Gloria-Deng/epv32/docs/附图/fig_a_operator_bars.png

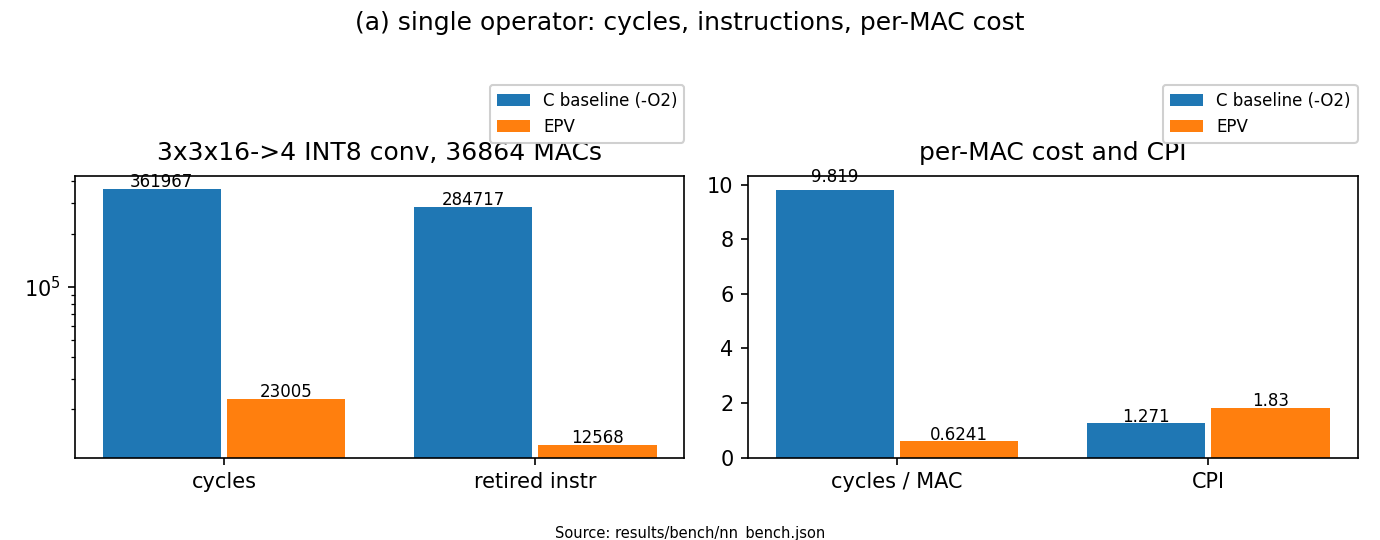
docs/附图/fig_a_operator_bars.png
