Gloria-Deng/epv32/docs/附图/fig_b_layer_stack.png

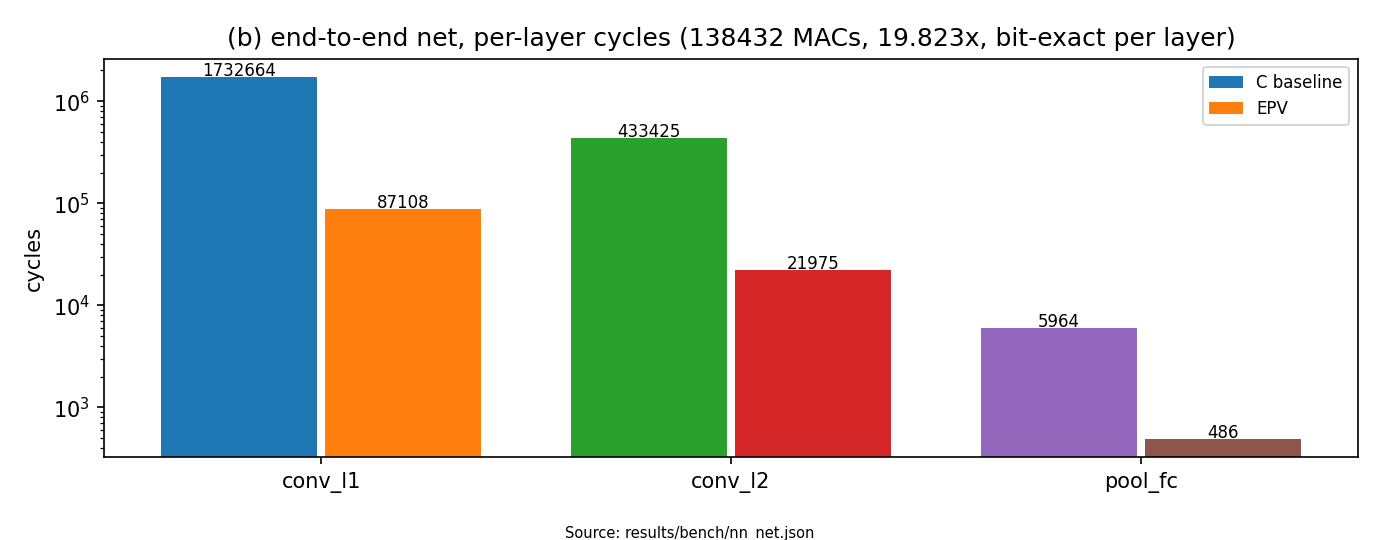
docs/附图/fig_b_layer_stack.png
