Gloria-Deng/epv32/docs/附图/fig_c_device_resources.png

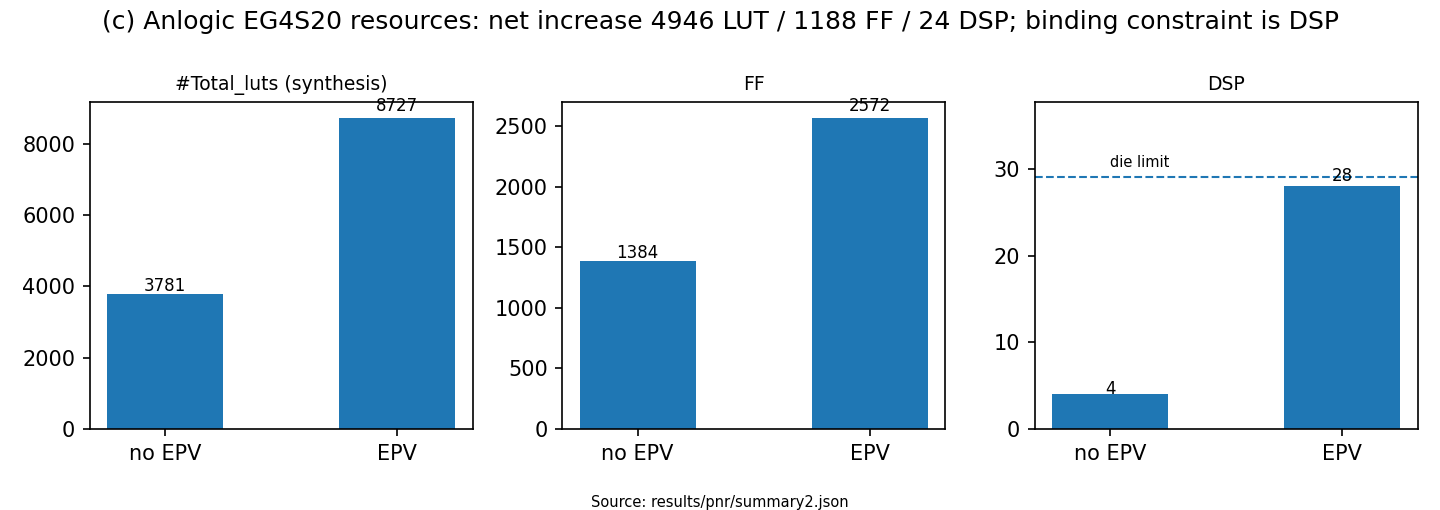
docs/附图/fig_c_device_resources.png
