Gloria-Deng/epv32/docs/附图/fig_d_speedup_waterfall.png

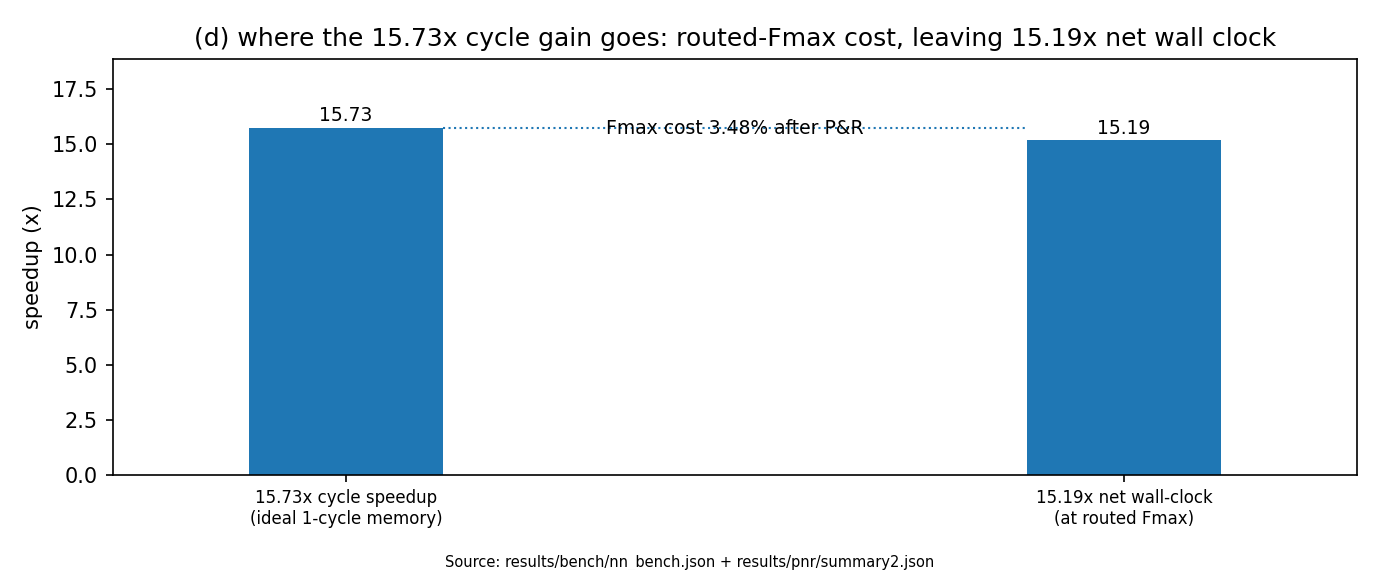
docs/附图/fig_d_speedup_waterfall.png
