Gloria-Deng/epv32/docs/附图/fig_e_compliance.png

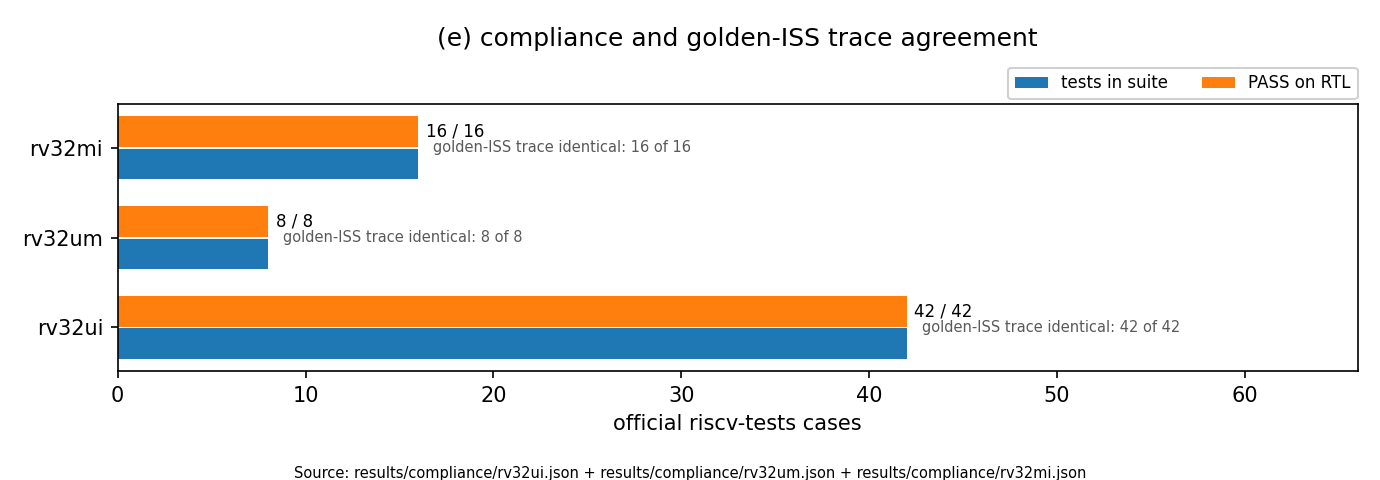
docs/附图/fig_e_compliance.png
