Gloria-Deng/epv32/docs/附图/fig_f_yosys_area.png

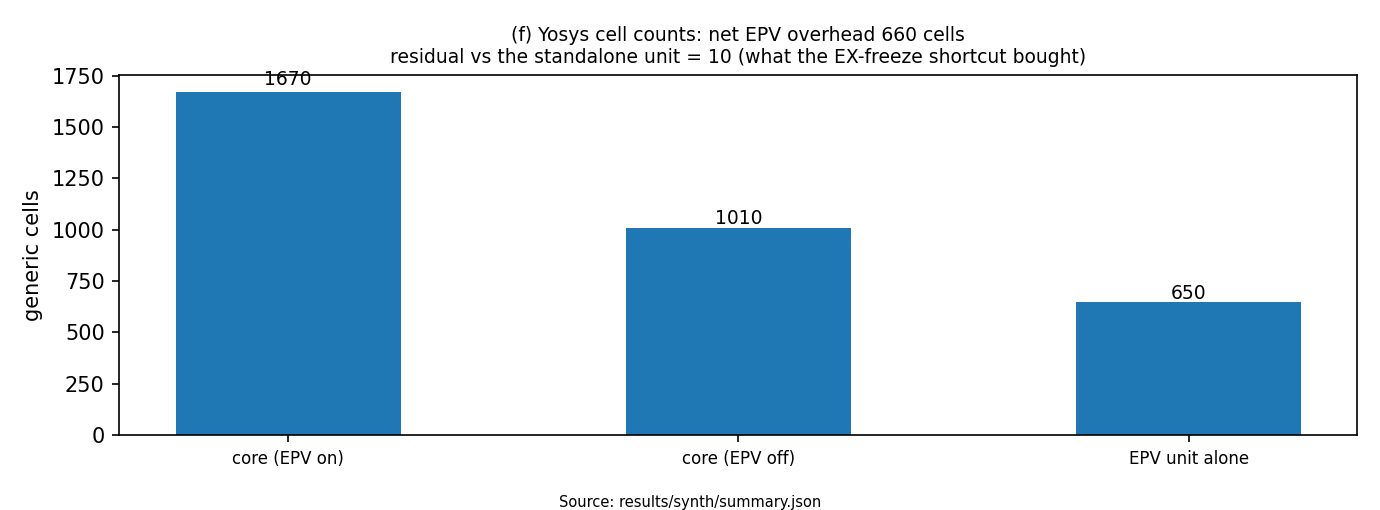
docs/附图/fig_f_yosys_area.png
