Gloria-Deng/epv32/docs/附图/fig_g_cifar10_accuracy.png

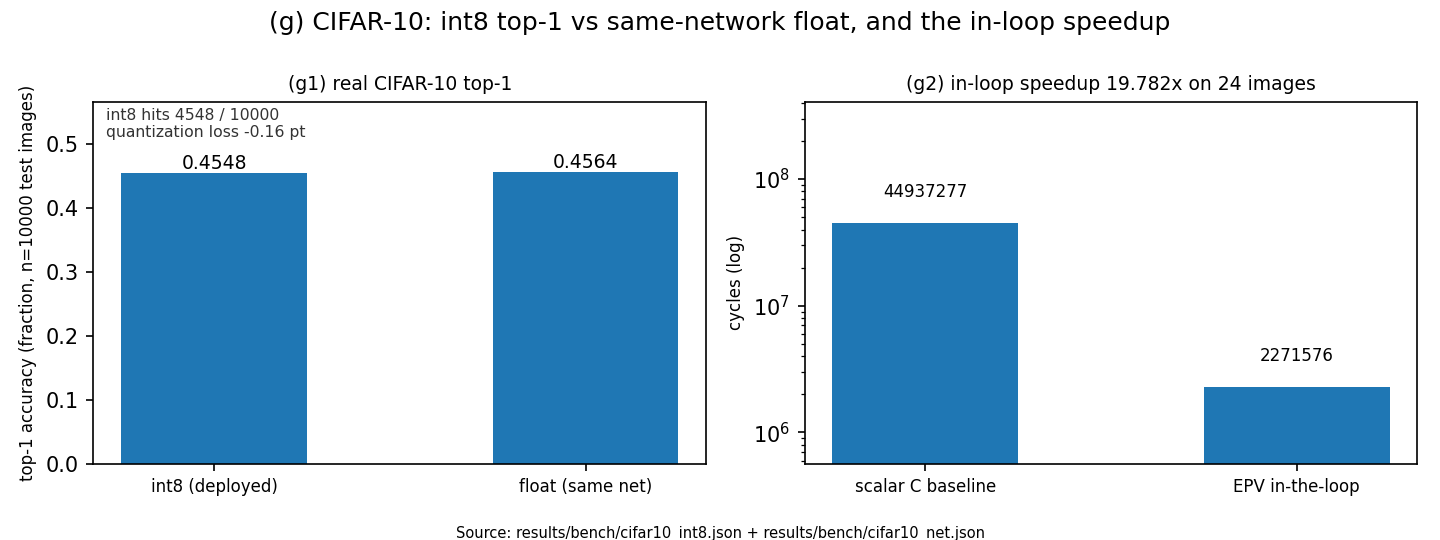
docs/附图/fig_g_cifar10_accuracy.png
