Gloria-Deng/epv32/docs/附图/fig_h_mem_penalty_curve.png

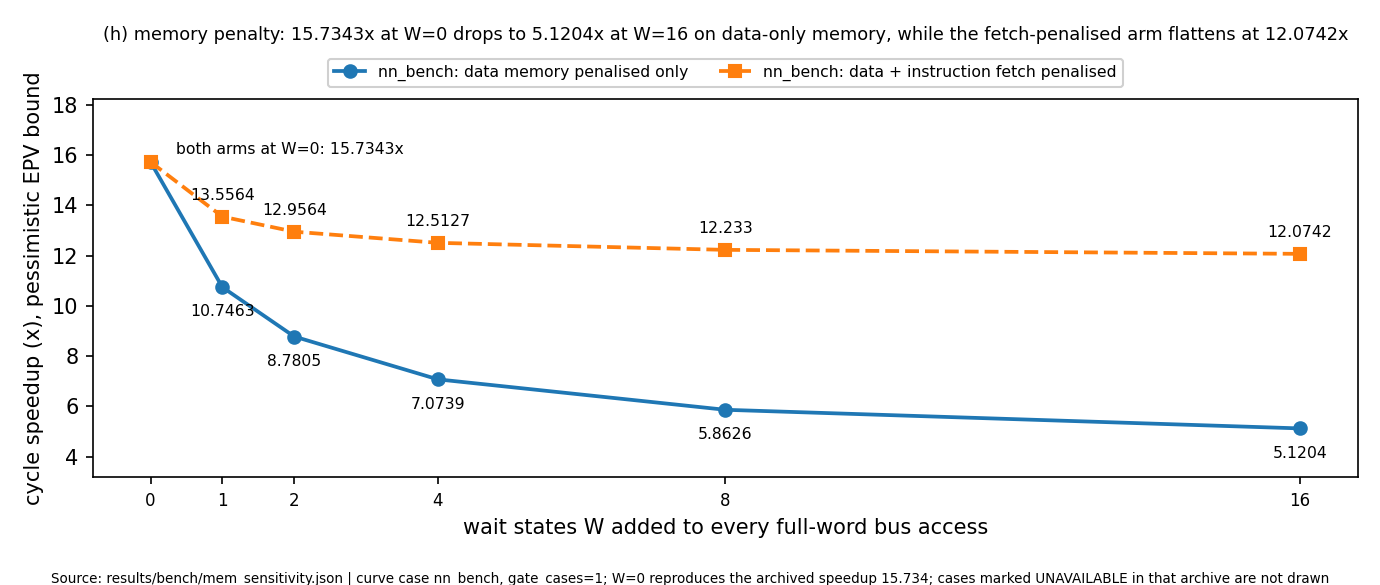
docs/附图/fig_h_mem_penalty_curve.png
