Gloria-Deng/epv32/tb/golden/epv_iss.py

#!/usr/bin/env python3
# -*- coding: utf-8 -*-
# =============================================================================
#  epv_iss.py -- GOLDEN REFERENCE INSTRUCTION-SET SIMULATOR for the EPV32 core
#
#  WHAT THIS IS
#    纯标准库 (Python 3.11) 的提交级指令模拟器, 覆盖 rtl/epv32_soc.v +
#    rtl/epv32_core.v (RV32IM + Zicsr + machine mode) 与自定义 EPV 扩展
#    (CUSTOM0/CUSTOM1)。它是核对 RTL 的黄金模型: 一次 step() == 一条退休指令,
#    与 o_tr_* 退休轨迹 1:1 对齐; 流水线停顿、32 拍除法器、4 拍 LVB/SVB 都折进单次提交。
#
#  SOURCE OF TRUTH (read these before changing anything in here)
#    rtl/epv32_defs.vh   opcodes / EPV encoding / memory map / exception codes
#    rtl/epv32_epv.v     exact arithmetic of every EPV operation
#    rtl/epv32_core.v    legality decode + trap priority + retire trace
#    rtl/epv32_csr.v     CSR behaviour, interrupt arbitration, mcycle/minstret
#    rtl/epv32_muldiv.v  RV32M corner cases
#    rtl/epv32_ram.v     byte addressed, 4 byte enables, index = addr[AW+1:2]
#
#  DELIBERATE DEVIATIONS FROM THE RTL
#    历史上这里有三条「模型按规范、RTL 有 bug」的开关。到 M8 为止三条都已经在
#    RTL 里修掉了，所以 MIRROR_RTL_DECODE_BUGS 现在**换不出任何行为差异**——
#    留着它不是为了兼容，而是为了让"合流"这件事本身可被反驳：自检里有一条断言
#    专核 rtl_* == spec_*，并且要求 legacy_*（旧 RTL 形状）确实与两者不同，
#    否则那条合流断言就是空跑。三条的来历：
#    MIRROR_RTL_DECODE_BUGS (default False)
#      (1) 旧 epv32_core.v 的 `imm_op_bad` 把每条 SLLI 都判非法、且把 SRAI
#          (inst[30]=1) 与 ORI(imm[10]=1) 一起判非法 —— rv32ui/add 在第一条
#          slli 就 cause=2。现行判据见上面 imm_bad_* 四个函数。
#      (2) 旧 `m_f3_ok` 只收 f3 ∈ {0,1,2,3,6,7}，于是 DIV(f3=4)/DIVU(f3=5)
#          被判非法 —— rv32um/div 栽过。现行 RTL 恒不判非法。
#      (3) 旧 `other_f3_bad` 对 LUI/AUIPC/JAL 也校验 [14:12]，而那是 U/J 型
#          立即数的一部分 —— 任何 imm[14:12]!=0 的 lui/auipc/jal 都陷入。
#          现行 RTL 只对 JALR 校验。
#    MIRROR_RTL_MTVEC_MODE_BIT (default False)
#      epv32_csr.v:81 `wire vmode_vec = mtvec[1];` decodes the vectored mode
#      from bit 1, but mtvec MODE is a 2-bit WARL field where 0 = Direct and
#      1 = Vectored, so the standard encoding mtvec = base|1 selects DIRECT and
#      base|2 selects VECTORED on this hardware -- the opposite of the spec (and
#      of the design brief).  Golden: (mtvec & 3) == 1 means vectored.
#    MIRROR_RTL_BRANCH_OPERAND_BUG (default False)
#      epv32_core.v:254 gives a BRANCH `d_b_imm=1`, and epv32_core.v:367 is
#      `assign alu_b = idex_b_imm ? idex_imm : fwd2;` -- so the branch ALU
#      computes rs1 OP branch_offset and BEQ/BNE/BLT/BGE test THAT result
#      (only BLTU/BGEU, which compare fwd1/fwd2 directly at line 405, work).
#      In hardware BEQ is therefore taken iff rs1 == offset, and BLT iff
#      rs1 < offset.  The golden model compares the two GPR operands; set the
#      flag True to reproduce the hardware's branch decisions exactly.
#    EPV_MEM_ADDR_STRIDE_X4 (default True)
#      Today's epv32_epv.v walks the four beats as base + wc*4 (four
#      consecutive words) -- which is what the golden default models.  Setting
#      it False reproduces the PRE-fix addressing bug (the ledger-defect-11
#      era: base + wc, so all four beats hit one word); the switch exists so
#      that historical failure mode stays reproducible, not because the
#      hardware still behaves that way.
#    EPV_MEM_IMM_UNUSED (default True)
#      The R-type migration removed the immediate from EPV.LVB / EPV.SVB
#      entirely: epv32_epv.v still takes i_imm but nothing consumes it, and
#      the transfer address is exactly rs1 + 4*beat.  The software intrinsic
#      keeps off in the base register for that reason (sw/inc/epv32_hw.h
#      epv_lvb).  Setting it False revives the I-type-era behaviour (adding
#      imm[11:0], zero- or sign-extended per EPV_IMM_ZERO_EXTENDS) so the old
#      encoding-collision analyses stay reproducible; quirk 17 records what
#      that era implied.
#
#  CYCLE MODEL v2 -- READ THIS BEFORE USING mtime / mcycle / UART STATUS / IRQs
#  (design brief item 5; v1 counted 1 cycle per retired instruction, which made
#   mcycle/mtime a lower bound and TIMER-IRQ timing "not a golden property".
#   That is gone: since the EPV trace comparison the ISS carries an EXACT
#   microarchitectural clock, validated point-by-point against the mcycle read
#   values the RTL records in its retirement traces.)
#    One step() == one retired instruction, AND a precise place on the RTL's
#    clock.  For instruction i the model computes the cycle where its EX stage
#    actively evaluates (reset fill: first instruction is in EX at cycle 2,
#    counting the first post-reset cycle as 0), then:
#      +1  load-use hazard: the previous instruction is a LOAD whose rd field
#          matches this instruction's rs1/rs2 FIELD, using the RTL's coarse
#          per-opcode uses_rs1/uses_rs2 wires (epv32_core.v:272-278) -- an EPV
#          op counts as using both fields even when it semantically does not;
#      +2  the previous instruction redirected (taken branch/jump, mret, trap
#          or IRQ): two flushed slots ahead of the target;
#      +1  the previous instruction was a word/half access CROSSING a word
#          boundary: its second MEM beat holds the pipeline one extra cycle
#          (only for single-cycle successors; a DIV/LVB started during that
#          hold absorbs it into its own busy count);
#     +32  DIV/REM/REMU/DIVU frozen in EX (1 start + 32 working beats,
#          epv32_muldiv.v "完成拍 = 第 33 拍");
#      4+g LVB/SVB: 4 granted bus beats; g = grant waits caused by the
#          previous instruction still occupying MEM (1 for a plain load/store,
#          2 if it crossed a word boundary; 0 when a load-use hazard already
#          delayed this instruction past the previous MEM beat).
#    Everything else is 1 cycle.  Bus reads sample the device state at the
#    instruction's MEM cycle (EX+1); LVB/SVB beats sample at their own beat
#    cycles; CSR reads sample mcycle at the EX cycle.  The UART send shift
#    register is modelled edge-by-edge (see _uart_edge), so a STATUS poll
#    returns the live tx_idle bit -- busy-wait loops now wait exactly as long
#    as the hardware does.  mtime is the real free-running clock; mcycle is
#    the same clock unless software writes it or inhibits it (overlay, see
#    _mcycle_now).  `cycles_per_step` / `set_cycle_model()` still exist as a
#    legacy escape hatch: setting either switches the ISS back to flat
#    per-step charging and disables the exact placement.
#    CONSEQUENCE: TIMER-IRQ timing and UART poll values ARE golden properties
#    now, and a mcycle read value in a retirement trace is a point check of
#    the whole model (all of them must match the RTL bit-for-bit).
#
#  RTL_QUIRKS mirrored faithfully by this model (deliberately NOT "fixed"):
#   1. Trap priority is exactly epv32_core.v:425-434: illegal > instruction
#      access fault > branch target > jump target > ebreak > ecall > address
#      misaligned > access fault.
#   2. Control-transfer targets are checked in EX with the SAME expression on
#      both sides: a branch is judged only when it is TAKEN (M5), and both
#      branch and jump targets must be in the memory map AND satisfy IALIGN=32
#      (M7: jalr already cleared bit0, so the alignment test looks at bit1).
#      Either way the cause is 0 with mtval = target.  History: before M5 a
#      not-taken branch trapped anyway; before M7 an in-range but halfword
#      misaligned target did NOT trap at all -- it fetched the aligned word and
#      used the misaligned address as PC, so auipc came out 2 bytes off
#      (measured: results/sim/misalign_bisect_pre_m7.json, uart "C2
#      flag=11ce0000").  Both deviations are gone; this entry documents what
#      the model must NOT reproduce.
#   3. (pre-M6 legacy, kept reachable) addr_ok() used to demand 4-byte
#      alignment for EVERY access, so LB/SB at addr%4!=0 reported LOAD/STORE
#      ACCESS FAULT (5/7).  Now the alignment tier follows the access width
#      (byte: none; half: addr[0]; word: addr[1:0]), and with SUPPORT_MISALIGNED
#      the core splits a crossing access in MEM instead of trapping.  Set
#      ADDR_OK_OLDED_ALIGNMENT=True to reproduce the legacy reading.
#   4. Exceptions enter at mtvec with the low two MODE BITS MASKED OFF
#      (epv32_core.v: `trap_target = irq_now ? csr_irq_target : csr_mtvec_base`
#      where csr_mtvec_base = {mtvec[31:2], 2'b00}); interrupts use
#      mtvec_base / the vectored offset.  An older core line selected o_mtvec
#      verbatim and the model mirrored that (the old quirk 4); under that
#      reading a vectored-mode mtvec sent exceptions to a misaligned address.
#      The CSR REGISTER still holds the raw mode bits unwritten (no WARL
#      masking on write) -- it is only the exception ENTRY that is masked.
#   5. LOAD with f3==7 is not rejected (ld_f3_bad covers only 3 and 6) and
#      behaves like LW; OP / OP-IMM with an unhandled funct3 fall through to ADD.
#   6. Undefined CSR address: reads 0, writes ignored, NO trap (documented in
#      epv32_csr.v:10-12 as an intentional boundary).  Read-only CSRs (mip,
#      misa, mvendorid..., vcfg) also swallow writes.  M9 moved mcycle*/
#      minstret* out of that list: they are writable and the writing
#      instruction suppresses its own increment (quirk 18).
#   7. CSRRS/CSRRC suppress the write when the FORWARDED DATA is 0, not when
#      the register number is x0 (epv32_csr.v:127 tests i_wdata == 32'h0).
#   8. MPP reads as 00 until the first trap / mret / mstatus write forces 11:
#      epv32_csr.v resets mstatus to 0 and only ever assigns bits 12:11.
#   9. mret retires nothing (ex_commit excludes mret_go), so minstret does not
#      count mret and the retire trace has no mret entry.
#  10. EPV field_bad (epv32_epv.v:96-98) is THREE PER-OP MASKS, not an
#      unconditional rd/rs2/rs1 check: rd_is_vec covers MVX plus every CUSTOM1
#      op except VDOT8; rs2_is covers LVB/SVB plus the two-source CUSTOM1 ops;
#      rs1_is covers CUSTOM1 except VDOT8/VZERO.  So XMV / CFG / CFGR / LVB /
#      SVB / VDOT8 all legally take rd >= 8, MVX / XMV / CFG / CFGR may carry
#      rs2[4:3] != 0, and no CUSTOM0 op checks rs1.  This model used to check
#      rd/rs2 unconditionally and its own self test pinned that (as "VDOT8
#      rd=8 -> illegal"); the RTL never rejected those encodings -- the whole
#      program trace comparison died on `EPV.CFGR x11`.  Corrected here and
#      re-pinned per-op, both directions, in self test section 10.
#  11. EPV.XMV reads the rs2 FIELD (epv32_epv.v `c0_xmv ? s2[31:0]`, "XMV 的
#      向量号在 [24:20] => s2"), matching sw/inc/epv32_hw.h epv_xmv(rd, vs2)
#      which puts vs2 in [24:20] and x0 in rs1.  An earlier RTL line read s1
#      and this model mirrored that as the old quirk 11 ("reads vrf[rs1f]");
#      the EPV trace comparison caught the staleness the day the UART cycle
#      model let it reach the first VDOT8 -- a vreg loaded via LVB came back
#      as lane-0-of-v0 instead of the requested vector.  Corrected here; the
#      field-presence legality (XMV's rd is a real GPR, rs2 is a vec number)
#      was already right and stands.
#  12. VREQ4 adds RB SIGN-EXTENDED (int8 zero point): the current epv32_epv.v
#      drives `rb_ext = {{56{v_rb[7]}}, v_rb}`.  History: the first RTL
#      concatenated {55'b0, v_rb} -- unsigned, so RB=0xFF added +255 instead
#      of -1 (ledger defect 13; the golden model flagged it and the old self
#      test only covered positive RB, which is why it could not see the bug).
#      This model mirrored the bug as the old quirk 12 and went stale when
#      the RTL got fixed; the EPV trace comparison caught that too
#      (epv_selftest read +127 where the hardware gives -30).  Both numbers
#      are still pinned, now pointing the right way.
#  13. EPV illegal encodings never reach the bus, and EPV LVB/SVB bus accesses
#      can never fault: the EPV datapath drives neither idex_mem_read nor
#      idex_mem_write, so misaligned/bus_err (gated on c_ld/c_st) cannot fire.
#  14. be_of()'s halfword arm tests off[0] (epv32_core.v:70) where off[1] is the
#      meaningful bit, so SH at addr%4==2 would get be=0b0011 instead of 0b1100.
#      Latent only: such a store never commits because addr_ok() rejects
#      addr%4!=0, so both readings agree on every reachable store.  Kept
#      verbatim for that reason.
#  15. Peripheral reads used to be CLOCKED (rdata <= ... in epv32_soc.v), so a
#      peripheral load returned the PREVIOUS peripheral access's value (STATUS
#      read 3 out of reset); the golden model flagged it (ledger defect 14) and
#      the RTL now drives rdata combinationally (epv32_soc.v:118-124).  The
#      model returns the CURRENT value, which is what today's RTL does; with
#      CYCLE MODEL v2 the UART side of "current" is exact (live tx_idle at the
#      load's MEM cycle), so a STATUS mismatch is once again always a bug.
#  16. epv32_defs.vh:117 documents SYSC CTRL bit0 as "allow commit to end the
#      sim" but epv32_sysc has no CTRL register: ANY write to offset 0 raises
#      commit.  Mirrored (a write to SYSC+0 halts whatever CTRL holds).
#  17. EPV.LVB / EPV.SVB are R-TYPE with the vector number in inst[24:20]
#      (rs2 field): LVB's DESTINATION vector is rs2f[2:0] (epv32_epv.v
#      `vrf[(c0_lvb ? mv_n : vd_n)]`, mv_n = i_rs2f), SVB's SOURCE vector is
#      rs2f[2:0] likewise, rd is x0 in every real encoding, and the immediate
#      field is dead (EPV_MEM_IMM_UNUSED).  On the retirement trace SVB is
#      INVISIBLE as a store: idex_mem_write=0 for CUSTOM0, so o_tr_memwr=0
#      and the testbench prints no S line for it -- the four bus beats exist
#      on the bus but not in the trace.  History: the first encoding was
#      I-type with imm12 = inst[31:20] covering the vs2 field, which made any
#      displacement with imm[4] or imm[3] set unencodable and made "EPV.SVB
#      v6, 0(x9)" transfer from x9+6; the model mirrored that era and its self
#      test pinned it (including four per-SVB store records that the RTL
#      trace never had).  After the R-type migration the collision is gone;
#      the surviving constraint is just the field_bad mask -- the vector
#      number must fit 0..7, i.e. inst[24:20][4:3] == 0 for LVB/SVB.
#  18. minstret / mcycle reads return the value BEFORE the reading instruction
#      counts itself.  As of M9 the RTL increments at the commit stage (EX)
#      rather than at WB -- see epv32_core.v's csr_cnt_wr note for the real
#      ordering bug that forced the move.  The model's observable is unchanged
#      (it counts in program order at commit), so this reading rule stands.
#  19. mcountinhibit.CY(bit0) stops mcycle in the RTL but NOT the SoC's mtime
#      (separate counters in separate modules).  CYCLE MODEL v2 split them:
#      `cycle` is the real free-running clock and drives mtime; the mcycle
#      mirror is an overlay on top of it that honours CY and counter writes
#      (_mcycle_now).  One deliberate simplification: on the edge where one
#      half of mcycle is written, the RTL still increments the OTHER half that
#      same edge (two NBAs, the write only overrides its own half); the overlay
#      suppresses that one increment.  No ISS-vs-RTL comparison reaches a
#      mcycle write today (the suites never read cycle CSRs; micro_bisect has
#      no golden-model arm), so nothing observable rests on the difference.
#      The core-side reading lives in sw/bench/micro_bisect.c item C7.
#  20. PMP *enforcement* (NAPOT/TOR/NA4 match + the three M-mode implicit
#      rules) is in the RTL and in sw/bench/micro_bisect.c, not in this model.
#      None of the three compliance suites can reach it (rv32mi ships pmpaddr
#      only, which tests CSR WARL), so leaving it out cannot mask a mismatch;
#      adding it would mean the trace comparison agrees for a reason it never
#      exercised.  Recorded as an uncovered model path, not as agreement.
# =============================================================================
"""Golden ISS for the EPV32 core: RV32IM + Zicsr + machine mode + EPV ext."""

import sys

__all__ = ["ISS", "StepResult", "Result", "Trap", "SimHalt",
           "ADDR_RAM_BASE", "ADDR_UART_BASE", "ADDR_TIMER_BASE",
           "ADDR_SYSC_BASE"]

# ------------------------------------------------------------------- tunables
MIRROR_RTL_DECODE_BUGS = False       # header deviations 1 and 4
MIRROR_RTL_BRANCH_OPERAND_BUG = False  # header deviation 4 (branches)
MIRROR_RTL_MTVEC_MODE_BIT = False      # header deviation 5 (mtvec mode decode)
EPV_MEM_ADDR_STRIDE_X4 = True        # hardware: four consecutive words
EPV_MEM_IMM_UNUSED = True            # hardware: R-type, the imm field is dead
EPV_IMM_ZERO_EXTENDS = True          # only consulted when EPV_MEM_IMM_UNUSED=0
# rtl/epv32_core.v 的 parameter SUPPORT_UNALIGNED 的镜像:
#   True  = 现在这份核的行为 —— 非对齐访存由硬件拆成两次对齐访问, 不陷入
#   False = 老核的行为 —— 按 cause 4/6 精确陷入
SUPPORT_MISALIGNED = True
# quirk 3 (老核的 addr_ok 要求任何访问都 4 字节对齐) 已经修掉了; 留开关,
# 因为轨迹比对靠的就是"两边同一时刻必须是同一份规则"。
ADDR_OK_OLDED_ALIGNMENT = False

# ------------------------------------------------- opcodes (epv32_defs.vh)
OP_LUI, OP_AUIPC, OP_JAL, OP_JALR, OP_BRANCH, OP_LOAD, OP_STORE = (
    0x37, 0x17, 0x6F, 0x67, 0x63, 0x03, 0x23)
OP_OPIMM, OP_OP, OP_FENCE, OP_SYSTEM, OP_CUSTOM0, OP_CUSTOM1 = (
    0x13, 0x33, 0x0F, 0x73, 0x0B, 0x2B)

# ------------------------------------------------------- ALU ops (defs.vh)
ALU_ADD, ALU_SUB, ALU_SLL, ALU_SLT, ALU_SLTU, ALU_XOR = 0, 1, 2, 3, 4, 5
ALU_SRL, ALU_SRA, ALU_OR, ALU_AND, ALU_MUL, ALU_DIV = 6, 7, 8, 9, 10, 11
ALU_PASS = 15

# ------------------------------------------------- memory map (epv32_defs)
ADDR_RAM_BASE, ADDR_RAM_LAST = 0x8000_0000, 0x8003_FFFF
ADDR_UART_BASE, ADDR_UART_LAST = 0x9000_0000, 0x9000_003F
ADDR_TIMER_BASE, ADDR_TIMER_LAST = 0x9001_0000, 0x9001_003F
ADDR_SYSC_BASE, ADDR_SYSC_LAST = 0x9002_0000, 0x9002_003F

UART_OF_DATA, UART_OF_STATUS, UART_OF_DIV = 0x0, 0x4, 0x8
TMR_OF_MTIME, TMR_OF_MTIMEHI, TMR_OF_CMP, TMR_OF_CMPHI = 0x0, 0x4, 0x8, 0xC
SYSC_OF_COMMIT, SYSC_OF_CTRL, SYSC_OF_SYSID = 0x0, 0x4, 0x8
SYSC_SYSID = 0xE01C_9A53

# ------------------------------------------------ exception codes (defs.vh)
EXC_IAFAIL_ALIGN, EXC_IAF, EXC_ILLEGAL, EXC_BREAK = 0, 1, 2, 3
EXC_LAMF, EXC_LAF, EXC_SAMF, EXC_SAF, EXC_ECM = 4, 5, 6, 7, 11
EXC_NAMES = {0: "instr-address-misaligned", 1: "instr-access-fault",
             2: "illegal-instruction", 3: "breakpoint",
             4: "load-address-misaligned", 5: "load-access-fault",
             6: "store-address-misaligned", 7: "store-access-fault",
             11: "ecall-from-machine-mode"}
IRQ_NAMES = {3: "machine-software-interrupt", 7: "machine-timer-interrupt",
             11: "machine-external-interrupt"}


# ------------------------------------------------ RV32M 的保留编码判据
# 四条规则放在一起，是因为「谁判非法」这件事上模型与 RTL 各有一份实现，
# 一旦两份不同步，逐条轨迹比对就会在某个奇怪的偏移上分叉 —— 而分叉既可能
# 是核错了也可能是模型错了（M8 这次是核错：官方 rv32mi/shamt 只有 ISS 过）。
#   spec   : RISC-V 卷 I（RV32 的 shamt 只有 5 位, inst[25] 必须为 0）
#   rtl    : epv32_core.v 的 imm_op_bad / muldiv_bad, 逐位镜像
#   legacy : M8 之前的 RTL, 只留给自检造反例用
def imm_bad_spec(op, f3, f7):
    return (op == OP_OPIMM) and ((f3 == 1 and f7 != 0x00) or
                                 (f3 == 5 and f7 not in (0x00, 0x20)))


def md_bad_spec(op, f3, f7):
    return False                      # RV32M 八个 funct3 全部合法


def imm_bad_rtl(op, f3, f7):
    return imm_bad_spec(op, f3, f7)   # M8 之后与规范合流


def md_bad_rtl(op, f3, f7):
    return md_bad_spec(op, f3, f7)    # 现在的 RTL 是 `&& !1'b1`, 恒不触发


def imm_bad_legacy(op, f3, f7):
    return (op == OP_OPIMM) and (f3 == 1 or (f3 == 5 and ((f7 >> 5) & 1))
                                 or (f3 == 6 and ((f7 >> 5) & 1)))


def md_bad_legacy(op, f3, f7):
    """旧 RTL 的 muldiv_bad：`m_f3_ok` 只收 {0,1,2,3,6,7}，DIV(4)/DIVU(5) 被漏掉。"""
    return (op == OP_OP) and (f7 == 0x01) and \
        not ((f3 <= 3) or (f3 == 6) or (f3 == 7))

MISA_VALUE = 0x4000_1200             # epv32_csr.v:96
IMPID_VALUE = 0x0000_0003            # epv32_core.v:23 parameter

# ---- M9: 与 rtl/epv32_csr.v 的 parameter / localparam 一一对应
PMP_N = 4                                  # epv32_csr.v parameter PMP_N
PMPCFG_WARL = 0x3F                    # L[0] R[1] W[2] X[3] A[5:4]
PMPADDR_WARL = 0x3FFF_FFFF            # G=0: bit31/30 无对应物理地址位
MCNTINHIBIT_WARL = 0x5                # 只有 CY(bit0) 与 IR(bit2)
CSR_COUNTER = (0xB00, 0xB80, 0xB02, 0xB82)
CSR_VCFG = 0x7C0                     # epv32_defs.vh:91
EPV_VRF_WORDS = 8                    # 8 x 128-bit vector registers

# ------------------------------------------- EPV funct3 / funct7 (defs.vh)
EPV_F3_LVB, EPV_F3_SVB, EPV_F3_MVX = 0, 1, 2
EPV_F3_XMV, EPV_F3_CFG, EPV_F3_CFGR = 3, 4, 5
EPV_F7_VDOT8, EPV_F7_VMAC4, EPV_F7_VADD8, EPV_F7_VREQ4 = 1, 2, 3, 4
EPV_F7_VMAX8, EPV_F7_VRELU8, EPV_F7_VSRA4, EPV_F7_VZERO = 5, 6, 7, 8
EPV_F7_VPOOL2, EPV_F7_VSUB8, EPV_F7_VMIN8 = 9, 10, 11
EPV_C0_F3_OK = frozenset(range(6))          # EPV_N_C0 = 6
EPV_C1_F7_OK = frozenset(range(1, 12))      # EPV_N_C1 = 11

# ---- epv32_epv.v:96-98 的三条"这个字段是向量号"掩码，逐指令类不同 (quirk 10)
#      不在掩码里的指令，那个字段就是真正的 GPR 编号 / 未被读的字段，允许 0..31。
EPV_RD_VEC_C0 = frozenset((EPV_F3_MVX,))                       # 除 XMV/CFGR/CFG/LVB/SVB
EPV_RS2_VEC_C0 = frozenset((EPV_F3_LVB, EPV_F3_SVB))           # MVX/XMV/CFG/CFGR 不查 rs2
EPV_RD_VEC_C1 = frozenset((EPV_F7_VMAC4, EPV_F7_VADD8, EPV_F7_VSUB8, EPV_F7_VMAX8,
                           EPV_F7_VMIN8, EPV_F7_VREQ4, EPV_F7_VRELU8, EPV_F7_VSRA4,
                           EPV_F7_VZERO, EPV_F7_VPOOL2))       # VDOT8 的 [11:7] 是 GPR
EPV_RS2_VEC_C1 = frozenset((EPV_F7_VMAC4, EPV_F7_VADD8, EPV_F7_VSUB8, EPV_F7_VMAX8,
                            EPV_F7_VMIN8, EPV_F7_VREQ4))       # 单源类不查 vs2
EPV_RS1_VEC_C1 = frozenset((EPV_F7_VMAC4, EPV_F7_VADD8, EPV_F7_VSUB8, EPV_F7_VMAX8,
                            EPV_F7_VMIN8, EPV_F7_VREQ4, EPV_F7_VRELU8, EPV_F7_VSRA4,
                            EPV_F7_VPOOL2))                    # VDOT8/VZERO 不查 vs1

MASK32 = 0xFFFF_FFFF
MASK64 = 0xFFFF_FFFF_FFFF_FFFF
MASK128 = (1 << 128) - 1


# ------------------------------------------------------------------- helpers
def u32(v):
    return v & MASK32


def s32(v):
    v &= MASK32
    return v - (1 << 32) if v >> 31 else v


def u64(v):
    return v & MASK64


def s64(v):
    v &= MASK64
    return v - (1 << 64) if v >> 63 else v


def s8(v):
    v &= 0xFF
    return v - 256 if v >> 7 else v


def sext(v, bits):
    m = (1 << bits) - 1
    v &= m
    return v - (1 << bits) if (v >> (bits - 1)) & 1 else v


def v_lane_i8(vec, i):
    """int8 lane i of a 128-bit vector: bits [8i+7:8i], signed."""
    return s8(vec >> (8 * i))


def v_lane_w(vec, j):
    """int32 lane j of a 128-bit vector: bits [32j+31:32j], signed."""
    return s32(vec >> (32 * j))


def v_put_byte(vec, i, b):
    return (vec & ~(0xFF << (8 * i))) | ((b & 0xFF) << (8 * i))


def v_put_word(vec, j, w):
    return (vec & ~(MASK32 << (32 * j))) | ((w & MASK32) << (32 * j))


def sat8_9(v, sat):
    """epv32_epv.v:109 sat8_9 -- 9-bit signed add/sub result."""
    if sat and v > 127:
        return 0x7F
    if sat and v < -128:
        return 0x80
    return v & 0xFF


def sat8_64(v):
    """epv32_epv.v:119 sat8_64 -- always saturates."""
    if v > 127:
        return 0x7F
    if v < -128:
        return 0x80
    return v & 0xFF


def trunc_div(a, b):
    """C-style truncating division (RISC-V DIV); Python's // floors."""
    q = abs(a) // abs(b)
    return q if (a < 0) == (b < 0) else -q


# ------------------------------------------------------------------- results
class SimHalt(Exception):
    """Raised when software writes the SYSC COMMIT register (epv32_soc.v:180).

    value = the data written; step = StepResult of the storing instruction, so
    the harness can still fold that final commit into its trace.
    """

    def __init__(self, value, step=None):
        super().__init__("SYSC COMMIT value=0x%08x" % (value & MASK32))
        self.value = value & MASK32
        self.step = step


class Trap(object):
    """Exception / interrupt descriptor (mirrors mcause / mtval / mepc)."""

    __slots__ = ("cause", "is_irq", "tval", "pc", "target", "name")

    def __init__(self, cause, is_irq, tval, pc, target):
        self.cause = cause & 0x1F
        self.is_irq = bool(is_irq)
        self.tval = tval & MASK32
        self.pc = pc & MASK32
        self.target = target & MASK32
        self.name = (IRQ_NAMES if self.is_irq else EXC_NAMES).get(
            self.cause, "cause-%d" % self.cause)

    @property
    def mcause(self):
        return ((1 << 31) if self.is_irq else 0) | self.cause

    def __repr__(self):
        return ("Trap(%s cause=%d is_irq=%s tval=0x%08x pc=0x%08x -> 0x%08x)"
                % (self.name, self.cause, self.is_irq, self.tval, self.pc,
                   self.target))


class StepResult(object):
    """One retired (or trapping) instruction.  Feeds the harness commit trace.

    rd / wdata follow epv32_core.v:542 rf_we, i.e. a write to x0 is NOT a
    commit (both stay None), matching o_tr_regwr.  mem_addr / mem_wdata /
    mem_be describe the single committed store of the common case; `stores`
    lists every committed store as (addr, wdata, be) -- EPV.SVB contributes
    four, an ordinary SW/SH/SB at most one.
    """

    __slots__ = ("pc", "instr", "rd", "wdata", "mem_addr", "mem_wdata",
                 "mem_be", "stores", "loads", "trap", "next_pc", "retired",
                 "vregs_written", "vcfg", "vcfg_written", "uart_bytes",
                 "halt", "kind", "csr_addr", "csr_old", "cycles", "epv")

    def __init__(self):
        self.pc = 0
        self.instr = 0
        self.rd = None
        self.wdata = None
        self.mem_addr = None
        self.mem_wdata = None
        self.mem_be = None
        self.stores = []
        self.loads = []
        self.trap = None
        self.next_pc = 0
        self.retired = False
        self.vregs_written = []
        self.vcfg = 0
        self.vcfg_written = False
        self.uart_bytes = b""
        self.halt = None
        self.kind = ""
        self.csr_addr = None
        self.csr_old = None
        self.cycles = 0
        self.epv = False

    def __repr__(self):
        if self.trap:
            return "Step(pc=0x%08x instr=0x%08x TRAP %s)" % (
                self.pc, self.instr, self.trap)
        out = ["Step(pc=0x%08x instr=0x%08x" % (self.pc, self.instr)]
        if self.rd is not None:
            out.append("x%d=0x%08x" % (self.rd, self.wdata))
        for a, d, b in self.stores:
            out.append("mem[0x%08x]=0x%08x/be=%x" % (a, d, b))
        for v in self.vregs_written:
            out.append("v%d=<128b>" % v)
        if self.vcfg_written:
            out.append("vcfg=0x%08x" % self.vcfg)
        out.append("-> 0x%08x)" % self.next_pc)
        return " ".join(out)


class Result(object):
    """Outcome of run()."""

    __slots__ = ("passed", "testnum", "n_instr", "uart_text", "halt_reason",
                 "commit_value", "trap")

    def __init__(self, passed, testnum, n_instr, uart_text, halt_reason,
                 commit_value=None, trap=None):
        self.passed = bool(passed)
        self.testnum = testnum
        self.n_instr = n_instr
        self.uart_text = uart_text
        self.halt_reason = halt_reason
        self.commit_value = commit_value
        self.trap = trap

    def __repr__(self):
        return ("Result(passed=%s testnum=%s n_instr=%d halt=%s uart=%r)"
                % (self.passed, self.testnum, self.n_instr, self.halt_reason,
                   self.uart_text))


class _Dec(object):
    """Decoded control word -- field for field the ID stage of epv32_core.v."""

    __slots__ = ("opcode", "f3", "f7", "rd", "rs1", "rs2", "imm_i", "imm_s",
                 "imm_b", "imm_u", "imm_j", "sys_code", "illegal",
                 "reg_write", "mem_read", "mem_write", "is_md", "is_epv",
                 "is_csr", "is_jmp", "is_br", "wr_pc4", "jal_is",
                 "do_ebreak", "do_ecall", "do_mret", "do_wfi", "alu_op",
                 "a_pc", "a_immu", "b_imm", "md_op", "imm", "is_c0",
                 "epv_illegal")

    def __init__(self):
        self.illegal = False
        self.reg_write = self.mem_read = self.mem_write = False
        self.is_md = self.is_epv = self.is_csr = False
        self.is_jmp = self.is_br = self.wr_pc4 = self.jal_is = False
        self.do_ebreak = self.do_ecall = self.do_mret = self.do_wfi = False
        self.alu_op = ALU_ADD
        self.a_pc = self.a_immu = self.b_imm = False
        self.md_op = 0
        self.imm = 0
        self.is_c0 = False
        self.epv_illegal = False


# ========================================================== the machine model
class ISS(object):
    """Core + SoC machine model.  See the module header for the ground rules."""

    def __init__(self, ram_words=65536, enable_epv=True):
        self.ram_words = ram_words
        self.enable_epv = enable_epv
        self.regs = [0] * 32                  # x0..x31
        self.vregs = [0] * EPV_VRF_WORDS      # 8 x 128-bit, one int each
        self.vcfg = 0
        self.ram = {}                         # word index -> 32-bit (sparse)
        self.uart_tx = bytearray()
        self.uart_div = 434
        self.mtimecmp = MASK64
        self.mtime_bias = 0                   # mtime = cycle + bias
        self.cycle = 0
        self.n_instr = 0                      # minstret (ex_commit count)
        self.mcountinhibit = 0
        self.pmpcfg = [0] * PMP_N
        self.pmpaddr = [0] * PMP_N
        self.pc = ADDR_RAM_BASE
        self.mstatus = self.mie = self.mtvec = 0
        self.mscratch = self.mepc = self.mcause = self.mtval = 0
        self.irq_soft = False                 # tied 0 in epv32_soc.v:247
        self.irq_ext = False                  # tied 0 in epv32_soc.v:247
        self._exact_cycles = True             # CYCLE MODEL v2; hooks switch it off
        self.cycles_per_step = 1
        self._cycle_model = None
        self._init_clock_state()
        self.steps = 0
        self._commit_req = None
        self.reset(ADDR_RAM_BASE)

    def _init_clock_state(self):
        """Clock-side state that survives load_image but not reset()."""
        # pipeline placement (CYCLE MODEL v2): last EX cycle of the previous
        # instruction; None until the first step after reset.
        self._last_ex = None
        self._prev = None
        # UART send shift register, one entry per RTL reg (epv32_uart.v:27-33).
        # _u_clk = cycle whose state is materialised; a DATA write performed at
        # bus cycle C is applied synchronously as the edge C -> C+1.
        self._u_run = False
        self._u_sh = 0x3FF                    # {idle, msb..lsb, start}, all idle
        self._u_cnt = 0
        self._u_bit = 0
        self._u_byte = 0
        self._u_start = False
        self._u_clk = 0
        # mcycle overlay: untouched -> mcycle IS the real clock (self.cycle).
        self._mcyc_touched = False
        self._mcyc_base = 0
        self._mcyc_land = 0                   # cycle from which _mcyc_base holds
        self._mcyc_frozen = False             # mcountinhibit.CY latched
        # per-instruction facts registered by _step_body for _record_prev
        self._cur_cross = False
        self._cur_memop = False
        self._cur_redirect = False
        self._cur_load_rd = None
        self._plan = None                     # placement of the current step
        self._cur_ex = 0                      # EX cycle of the current step

    # --------------------------------------------------------- lifecycle
    def reset(self, start_pc):
        """Reset core + SoC state.  RAM survives (load before or after)."""
        self.pc = start_pc & MASK32
        self.regs = [0] * 32
        self.vregs = [0] * EPV_VRF_WORDS
        self.vcfg = 0
        self.uart_tx = bytearray()
        self.uart_div = 434
        self.mtimecmp = MASK64
        self.mtime_bias = 0
        self.cycle = 0
        self.n_instr = 0
        self.steps = 0
        self.mcountinhibit = 0
        self.pmpcfg = [0] * PMP_N
        self.pmpaddr = [0] * PMP_N
        self.mstatus = self.mie = self.mtvec = 0
        self.mscratch = self.mepc = self.mcause = self.mtval = 0
        self.irq_soft = self.irq_ext = False
        self._commit_req = None
        self._init_clock_state()

    def set_cycle_model(self, fn):
        """Legacy escape hatch: fn(iss, step_index, pc, instr) -> cycles charged
        at the END of that step.  Setting a model (or a cycles_per_step != 1)
        switches the ISS back to flat per-step charging and DISABLES the exact
        pipeline placement of CYCLE MODEL v2 -- UART poll values and TIMER-IRQ
        timing stop being golden properties until you pass fn=None again."""
        self._cycle_model = fn
        self._exact_cycles = fn is None

    def _get_cps(self):
        return self._cps

    def _set_cps(self, v):
        self._cps = v
        self._exact_cycles = self._exact_cycles and (v == 1)

    cycles_per_step = property(_get_cps, _set_cps,
                               doc="flat per-step charge; != 1 switches the "
                                   "ISS to legacy cycle accounting")

    # ------------------------------------------------- exact clock helpers
    def _uart_edge(self, wr_byte=None):
        """One posedge of epv32_uart's send side, applied to the state of
        cycle self._u_clk; produces the state of cycle _u_clk+1.

        `wr_byte` mirrors `en && we && off==UART_OF_DATA` being active during
        the CURRENT cycle: the RTL captures tx_byte/tx_start at the edge that
        ENDS that cycle (epv32_uart.v:55-61).  The load condition
        `tx_start && tx_idle` is evaluated with the OLD tx_start, so a char
        written at cycle C starts shifting at C+2 and holds tx_run for exactly
        10*divisor cycles (C+2 .. C+2+10*div-1) -- verified against the
        busy-wait polls in the RTL retirement traces."""
        c = self._u_clk
        start, run = self._u_start, self._u_run
        cnt, bit, sh, tbyte = self._u_cnt, self._u_bit, self._u_sh, self._u_byte
        div = self.uart_div if self.uart_div else 1
        if wr_byte is not None:
            self._u_byte = wr_byte & 0xFF
            self._u_start = True
        else:
            self._u_start = False
        if start and not run:                 # load: {stop, data[7:0], start}
            self._u_sh = 0x200 | ((tbyte & 0xFF) << 1)
            self._u_run = True
            self._u_cnt = 0
            self._u_bit = 0
        elif run:
            if cnt == div - 1:
                self._u_sh = 0x200 | (sh >> 1)
                self._u_cnt = 0
                if bit == 9:
                    self._u_run = False
                else:
                    self._u_bit = bit + 1
            else:
                self._u_cnt = cnt + 1
        self._u_clk = c + 1

    def _uart_sync(self, target):
        """Advance the UART model to the state of cycle `target`."""
        t = max(0, int(target))
        while self._u_clk < t:
            self._uart_edge()

    @property
    def _tx_idle(self):
        """UART STATUS bit0 = !tx_run, at the currently materialised cycle."""
        return not self._u_run

    def _mcycle_now(self):
        """mcycle mirror at clock point self.cycle (CYCLE MODEL v2).

        Untouched -> the counter IS the real clock.  After a write or a
        mcountinhibit.CY latch it continues affinely from the recorded base
        (the write lands on the edge that ends the writing instruction's EX
        cycle, i.e. it is visible from land = ex+1)."""
        if not self._mcyc_touched:
            return u64(self.cycle)
        if self._mcyc_frozen:
            return u64(self._mcyc_base)
        return u64(self._mcyc_base + max(0, self.cycle - self._mcyc_land))

    def _mcycle_write(self, addr, data, ex_cycle):
        """Counter-half write landing at edge ex_cycle -> ex_cycle+1.

        Deliberate simplification (quirk 19): the RTL's OTHER half still
        increments on that edge (two NBAs); here the write replaces the whole
        recorded base, so that one increment is not modelled."""
        cur = int(self._mcycle_now())
        if addr == 0xB00:
            val = (cur & 0xFFFF_FFFF_0000_0000) | (data & MASK32)
        else:
            val = (cur & MASK32) | ((data & MASK32) << 32)
        self._mcyc_touched = True
        self._mcyc_frozen = False
        self._mcyc_base = u64(val)
        self._mcyc_land = ex_cycle + 1

    def _mcycle_inhibit(self, data, ex_cycle):
        """mcountinhibit write: CY(bit0) freezes mcycle from ex_cycle+1 on."""
        if data & 1 and not self._mcyc_frozen:
            # the increment on the writing edge still happens (old CY was 0)
            self._mcyc_touched = True
            self._mcyc_base = u64(int(self._mcycle_now()) + 1)
            self._mcyc_land = ex_cycle + 1
            self._mcyc_frozen = True
        elif not (data & 1) and self._mcyc_frozen:
            self._mcyc_land = ex_cycle + 1     # base stays; counting resumes
            self._mcyc_frozen = False
        self._mcyc_touched = self._mcyc_touched or bool(data & 1)

    # ------------------------------------------------- pipeline placement
    @staticmethod
    def _uses_rs1(d):
        """epv32_core.v:272-275 verbatim (raw opcode fields, legality aside)."""
        op = d.opcode
        return (op in (OP_OP, OP_OPIMM, OP_BRANCH, OP_LOAD, OP_STORE, OP_JALR)
                or (op == OP_SYSTEM and d.f3 != 0 and not (d.f3 & 4))
                or op in (OP_CUSTOM0, OP_CUSTOM1))

    @staticmethod
    def _uses_rs2(d):
        """epv32_core.v:276-278 verbatim."""
        op = d.opcode
        return (op in (OP_OP, OP_BRANCH, OP_STORE)
                or (op == OP_SYSTEM and d.f3 != 0 and not (d.f3 & 4))
                or op in (OP_CUSTOM0, OP_CUSTOM1))

    def _place_ex(self, d):
        """CYCLE MODEL v2: cycle where this instruction's EX stage actively
        evaluates, plus the placement facts its own bus accesses need.

        Returns (plan, last_ex): plan is a dict with
          active -- the EX cycle CSR reads sample (mcycle) and the IRQ check
                    samples (mtime >= mtimecmp);
          fe/g0  -- LVB/SVB only: first beat cycle and the grant waits ahead
                    of beat 0 (the previous instruction still sitting in MEM);
          last   -- the cycle whose closing edge commits this instruction
                    (EX/MEM capture), i.e. its LAST EX cycle.
        """
        if self._prev is None:
            # reset fill: IF during cycle 0, ID during 1, first EX during 2.
            L, redirect, load_rd, cross, memop = 1, False, None, False, False
        else:
            p = self._prev
            L = p["last"]
            redirect, load_rd = p["redirect"], p["load_rd"]
            cross, memop = p["cross"], p["memop"]
        # two flushed slots on redirect: the target is fetched during L+1,
        # in ID during L+2, in EX during L+3.  After a redirect there is no
        # load-use hazard (the flushed slots separate the load from its
        # consumer) and no crossing-MEM hold (a redirecting instruction is
        # never a load/store) -- but the target itself can still be a
        # multi-cycle DIV/LVB/SVB, so this only fixes fe and FALLS THROUGH
        # to the multi-cycle logic below.  (An earlier version returned
        # early here and charged every post-redirect instruction 1 cycle;
        # the EPV loops in sw/bench pay +3 cycles per iteration for exactly
        # that reason -- the replay probe caught it against the RTL wave.)
        fe = L + 3 if redirect else L + 1
        if not redirect and load_rd is not None and (
                (self._uses_rs1(d) and d.rs1 == load_rd)
                or (self._uses_rs2(d) and d.rs2 == load_rd)):
            fe += 1                       # load-use hazard: one ID stall
        is_div = d.is_md and d.md_op in (4, 5, 6, 7)
        is_move = (d.is_epv and d.is_c0
                   and d.f3 in (EPV_F3_LVB, EPV_F3_SVB))
        if is_div:
            # 1 start + 32 working beats in EX (epv32_muldiv.v: 完成拍=第33拍).
            # A crossing predecessor's MEM hold overlaps the divider's own
            # first busy beat, so it costs nothing extra here.
            last = fe + 32
            return {"active": last, "fe": fe, "g0": 0, "last": last}, last
        if is_move:
            # 4 granted beats; the previous MEM occupant blocks the beats that
            # would overlap it (ex_commit is 0 for the rest of the freeze, so
            # MEM fills with bubbles after that).
            g0 = 0
            if memop and not redirect:
                g0 = sum(1 for c in ([L + 1] + ([L + 2] if cross else []))
                         if c >= fe)
            last = fe + g0 + 3
            return {"active": last, "fe": fe, "g0": g0, "last": last}, last
        # single-cycle EX; a crossing predecessor's second MEM beat holds the
        # pipeline one extra cycle before this instruction's EX is live.
        active = fe + (1 if (cross and not redirect) else 0)
        return {"active": active, "fe": active, "g0": 0, "last": active}, active

    def _record_prev(self, plan):
        """Facts the NEXT step's placement needs (CYCLE MODEL v2).

        self._cur_cross / self._cur_redirect are registered by _step_body at
        the point the facts become known (cross when the access is classified,
        redirect on every control-transfer exit path)."""
        self._prev = {
            "last": plan["last"],
            "redirect": bool(self._cur_redirect),
            "load_rd": self._cur_load_rd,
            "cross": bool(self._cur_cross),
            "memop": bool(self._cur_memop),
        }

    def load_image(self, base_addr, data):
        """Little-endian blob into RAM, byte granular (any length / offset)."""
        a = base_addr & MASK32
        for i, b in enumerate(data):
            addr = (a + i) & MASK32
            w = (addr >> 2) & (self.ram_words - 1)
            sh = (addr & 3) * 8
            cur = self.ram.get(w, 0)
            self.ram[w] = u32((cur & ~(0xFF << sh)) | ((b & 0xFF) << sh))

    # -------------------------------------------------------- address decode
    @staticmethod
    def _in(a, lo, hi):
        return lo <= a <= hi

    def addr_ok(self, a):
        """Inside a decoded window.  The OLD core also demanded 4-byte
        alignment for every access (quirk 3); that is off by default now, kept
        reachable through ADDR_OK_OLDED_ALIGNMENT so a run can reproduce it."""
        a &= MASK32
        if ADDR_OK_OLDED_ALIGNMENT and (a & 3):
            return False
        return (self._in(a, ADDR_RAM_BASE, ADDR_RAM_LAST)
                or self._in(a, ADDR_UART_BASE, ADDR_UART_LAST)
                or self._in(a, ADDR_TIMER_BASE, ADDR_TIMER_LAST)
                or self._in(a, ADDR_SYSC_BASE, ADDR_SYSC_LAST))

    def _ram_peek(self, a):
        """Raw RAM read; mirrors epv32_ram.v's masked index addr[AW+1:2]."""
        return self.ram.get((a >> 2) & (self.ram_words - 1), 0)

    def _fetch(self, a):
        """Fetch.  Never faults here: epv32_core.v:416 raises the access fault
        from addr_ok(idex_pc) on top of whatever the port returned."""
        return self._ram_peek(a)

    def _read_word(self, a):
        """Bus read, address decoded.  Golden: combinational (see quirk 15).

        Device state is sampled at self.cycle (the caller sets it to the
        access's MEM cycle for loads/stores, or to the LVB/SVB beat cycle):
        the UART is advanced edge-by-edge to that point and STATUS returns the
        live tx_idle bit; mtime is the free-running clock at that point."""
        a &= MASK32
        off = a & 0x3F
        if self._in(a, ADDR_UART_BASE, ADDR_UART_LAST):
            if off == UART_OF_DATA:
                return 0                       # {23'b0, rx_valid, rx_data}
            if off == UART_OF_STATUS:
                self._uart_sync(self.cycle)
                return 1 if self._tx_idle else 0   # {30'b0, rx_valid, tx_idle}
            if off == UART_OF_DIV:
                return self.uart_div & MASK32
            return 0
        if self._in(a, ADDR_TIMER_BASE, ADDR_TIMER_LAST):
            m = self.mtime
            if off == TMR_OF_MTIME:
                return m & MASK32
            if off == TMR_OF_MTIMEHI:
                return (m >> 32) & MASK32
            if off == TMR_OF_CMP:
                return self.mtimecmp & MASK32
            if off == TMR_OF_CMPHI:
                return (self.mtimecmp >> 32) & MASK32
            return 0
        if self._in(a, ADDR_SYSC_BASE, ADDR_SYSC_LAST):
            return SYSC_SYSID if off == SYSC_OF_SYSID else 0
        return self._ram_peek(a)

    def _write_word(self, a, data, be):
        """Bus write with byte enables.  Returns the bytes this write TXed.

        The write is active during cycle self.cycle; the RTL captures it at
        the edge ENDING that cycle, so clocked side effects (UART tx_byte /
        tx_start, mtime re-base) are applied synchronously as the edge
        self.cycle -> self.cycle+1 and the clock point advances past it."""
        a &= MASK32
        data &= MASK32
        off = a & 0x3F
        if self._in(a, ADDR_UART_BASE, ADDR_UART_LAST):
            if off == UART_OF_DATA:
                b = data & 0xFF
                self._uart_sync(self.cycle)    # materialise the write cycle
                self._uart_edge(b)             # tx_byte/tx_start at this edge
                self.cycle += 1
                self.uart_tx.append(b)
                return bytes((b,))
            if off == UART_OF_DIV:
                d = data & 0xFFFF
                self._uart_sync(self.cycle)
                self._uart_edge()              # divisor lands on this edge
                self.cycle += 1
                self.uart_div = 1 if d == 0 else d
            return b""
        if self._in(a, ADDR_TIMER_BASE, ADDR_TIMER_LAST):
            # mtime ticks every cycle; the write lands on the edge that ends
            # this one, so the value visible from cycle+1 is (mtime+1) with
            # the written half replaced (the +1 is the 64-bit tick itself).
            m_now = u64(self.mtime + 1)
            if off in (TMR_OF_MTIME, TMR_OF_MTIMEHI):
                if off == TMR_OF_MTIME:
                    m = u64((m_now & 0xFFFF_FFFF_0000_0000) | data)
                else:
                    m = u64((m_now & MASK32) | ((data & MASK32) << 32))
                self.cycle += 1
                self.mtime_bias = u64(m - self.cycle)
            elif off == TMR_OF_CMP:
                self.mtimecmp = u64((self.mtimecmp & ~MASK32) | data)
            elif off == TMR_OF_CMPHI:
                self.mtimecmp = u64((self.mtimecmp & MASK32)
                                    | ((data & MASK32) << 32))
            return b""
        if self._in(a, ADDR_SYSC_BASE, ADDR_SYSC_LAST):
            # epv32_sysc.v:180 -- offset 0 raises commit, CTRL is not modelled
            if off == SYSC_OF_COMMIT:
                self._commit_req = data
            return b""
        w = (a >> 2) & (self.ram_words - 1)
        cur = self.ram.get(w, 0)
        new = cur
        for i in range(4):
            if (be >> i) & 1:
                sh = i * 8
                new = u32((new & ~(0xFF << sh)) | (((data >> sh) & 0xFF) << sh))
        self.ram[w] = new
        return b""

    # ---------------------------------------------------------- peripherals
    @property
    def mtime(self):
        return u64(self.cycle + self.mtime_bias)

    @property
    def timer_pending(self):
        return self.mtime >= self.mtimecmp

    @property
    def mip(self):
        """epv32_csr.v:60 -- wired OR of the interrupt lines, read-only."""
        v = 0
        if self.irq_soft:
            v |= 1 << 3
        if self.timer_pending:
            v |= 1 << 7
        if self.irq_ext:
            v |= 1 << 11
        return v

    # ------------------------------------------------------------------ CSRs
    def _csr_read(self, addr):
        addr &= 0xFFF
        if addr == 0x300:
            return self.mstatus & 0x1888                    # MIE/MPIE/MPP
        if addr == 0x301:
            return MISA_VALUE
        if addr == 0x304:
            return self.mie
        if addr == 0x305:
            return self.mtvec
        if addr == 0x340:
            return self.mscratch
        if addr == 0x341:
            return self.mepc
        if addr == 0x342:
            return self.mcause
        if addr == 0x343:
            return self.mtval
        if addr == 0x344:
            return self.mip
        if addr == CSR_VCFG:
            return self.vcfg if self.enable_epv else 0
        if addr in (0xB00, 0xC00):
            return self._mcycle_now() & MASK32
        if addr in (0xB80, 0xC80):
            return (self._mcycle_now() >> 32) & MASK32
        if addr in (0xB02, 0xC02):
            return self.n_instr & MASK32
        if addr in (0xB82, 0xC82):
            return (self.n_instr >> 32) & MASK32
        if addr == 0x320:
            return self.mcountinhibit & MCNTINHIBIT_WARL
        if addr == 0x3A0:
            return sum((self.pmpcfg[k] & PMPCFG_WARL) << (8 * k)
                       for k in range(PMP_N))
        if 0x3B0 <= addr <= 0x3B0 + PMP_N - 1:
            return self.pmpaddr[addr - 0x3B0] & PMPADDR_WARL
        if addr in (0xF11, 0xF12, 0xF14):
            return 0
        if addr == 0xF13:
            return IMPID_VALUE
        return 0                             # undefined: reads 0, no trap

    def _csr_write(self, addr, data):
        """epv32_csr.v:154-169 -- only these seven accept a write."""
        addr &= 0xFFF
        data &= MASK32
        if addr == 0x300:
            self.mstatus = u32((self.mstatus & ~0x1888) | (data & 0x88)
                               | 0x1800)                    # MPP <- 11 always
        elif addr == 0x304:
            self.mie = data
        elif addr == 0x305:
            self.mtvec = data                               # no WARL masking
        elif addr == 0x340:
            self.mscratch = data
        elif addr == 0x341:
            self.mepc = u32(data & 0xFFFF_FFFE)
        elif addr == 0x342:
            self.mcause = data
        elif addr == 0x343:
            self.mtval = data
        elif addr in CSR_COUNTER:
            # M9: 计数器可写。两半 composing 成同一个 64 位量 —— 自检里有
            # 一条专门把 0xFFFF_FFFF_FFFF_FFFF + 1 打到 0, 挡住「两半各自独立」
            # 这一类退回 (实测 rv32mi/instret_overflow 就是靠这条抓出来的)。
            if addr in (0xB00, 0xB80):
                # CYCLE MODEL v2: mcycle 的镜像有自己的 overlay (CYCLE MODEL
                # 块与 quirk 19) —— self.cycle 是墙钟, 不能被计数器写劫持。
                self._mcycle_write(addr, data, getattr(self, "_cur_ex", 0))
            elif addr == 0xB02:
                self.n_instr = (self.n_instr & 0xFFFF_FFFF_0000_0000) | data
            else:
                self.n_instr = (self.n_instr & 0xFFFF_FFFF) | (data << 32)
        elif addr == 0x320:
            self.mcountinhibit = data & MCNTINHIBIT_WARL
            self._mcycle_inhibit(data, getattr(self, "_cur_ex", 0))
        elif addr == 0x3A0:
            for k in range(PMP_N):
                if not (self.pmpcfg[k] & 1):      # L=1 => 复位前不可改
                    self.pmpcfg[k] = ((data >> (8 * k)) & 0xFF) & PMPCFG_WARL
        elif 0x3B0 <= addr <= 0x3B0 + PMP_N - 1:
            k = addr - 0x3B0
            if not (self.pmpcfg[k] & 1):          # 锁定的表项连 addr 一起保护
                self.pmpaddr[k] = data & PMPADDR_WARL
        # default: read-only or undefined -> silently ignored, no trap

    # ---------------------------------------------------------------- decode
    def _decode(self, instr):
        d = _Dec()
        op = d.opcode = instr & 0x7F
        f3 = d.f3 = (instr >> 12) & 7
        f7 = d.f7 = (instr >> 25) & 0x7F
        d.rd = (instr >> 7) & 0x1F
        d.rs1 = (instr >> 15) & 0x1F
        d.rs2 = (instr >> 20) & 0x1F
        d.imm_i = u32(sext(instr >> 20, 12))
        d.imm_s = u32(sext(((instr >> 25) << 5) | ((instr >> 7) & 0x1F), 12))
        b31 = (instr >> 31) & 1
        d.imm_b = u32(sext((b31 << 12) | (((instr >> 7) & 1) << 11)
                           | (((instr >> 25) & 0x3F) << 5)
                           | (((instr >> 8) & 0xF) << 1), 13))
        d.imm_u = u32(instr & 0xFFFF_F000)
        d.imm_j = u32(sext((b31 << 20) | (((instr >> 12) & 0xFF) << 12)
                           | (((instr >> 20) & 1) << 11)
                           | (((instr >> 21) & 0x3FF) << 1), 21))
        d.sys_code = (instr >> 20) & 0xFFFFF
        d.imm = d.imm_i

        op_known = op in (OP_LUI, OP_AUIPC, OP_JAL, OP_JALR, OP_LOAD,
                          OP_STORE, OP_OPIMM, OP_OP, OP_FENCE, OP_SYSTEM,
                          OP_BRANCH)
        op_custom = op in (OP_CUSTOM0, OP_CUSTOM1)

        # ---- 移位/乘除的非法编码判据：规范侧一份，RTL 侧一份。
        # M8 之后 epv32_core.v 的 imm_op_bad 与规范一致（SLLI 要 inst[31:25]==0；
        # SRLI/SRAI 要 ∈{0,0x20}），muldiv_bad 恒不触发（RV32M 八个 funct3 全合法），
        # 所以两份规则现在**逐位相同**。两个名字都留着：合流是"今天"的事实而不是
        # 永久属性 —— 自检里有一条断言专核 rtl_* == good_*，RTL 一旦回退，那条就红，
        # MIRROR_RTL_DECODE_BUGS 这个开关也重新有意义（历史上它镜像过「每条 SLLI 都
        # 非法」与「DIV/DIVU 被判非法」两版真缺陷，rv32ui/add 与 rv32um/div 都栽过）。
        # 三条规则都是模块级函数：解码处与自检处读同一份实现，不各写一遍。
        imm_op_bad = (imm_bad_rtl(op, f3, f7) if MIRROR_RTL_DECODE_BUGS
                      else imm_bad_spec(op, f3, f7))
        muldiv_bad = (md_bad_rtl(op, f3, f7) if MIRROR_RTL_DECODE_BUGS
                      else md_bad_spec(op, f3, f7))

        reg_op_bad = (op == OP_OP) and f7 not in (0x00, 0x20, 0x01)
        sys_bad = ((op == OP_SYSTEM) and f3 == 0
                   and d.sys_code not in (0x00000, 0x00001, 0x00302, 0x00105))
        csr_f3_bad = (op == OP_SYSTEM) and f3 not in (0, 1, 2, 3, 5, 6, 7)
        br_f3_bad = (op == OP_BRANCH) and f3 in (2, 3)
        ld_f3_bad = (op == OP_LOAD) and f3 in (3, 6)
        st_f3_bad = (op == OP_STORE) and f3 > 2
        # LUI / AUIPC 是 U 型、JAL 是 J 型：inst[14:12] 属于它们的立即数, 只有
        # JALR 的 [14:12] 是真 funct3。旧 RTL 对四者都校验, 于是
        # `lui x3,0x12345`、`jal x0,0x1000` 全被判非法; M8 之前修好。
        # 自检里 other_f3_legacy() 留着那个形状, 用来证明这条判据确实在管事。
        other_f3_bad = (op == OP_JALR and f3 != 0)
        illegal_id = ((not op_known and not op_custom) or imm_op_bad
                      or reg_op_bad or muldiv_bad or sys_bad or csr_f3_bad
                      or br_f3_bad or ld_f3_bad or st_f3_bad or other_f3_bad)

        if illegal_id or (not self.enable_epv and op_custom):
            d.illegal = True
            d.alu_op = ALU_PASS
            return d

        if op == OP_LUI:
            d.reg_write, d.a_immu = True, True
            d.imm, d.alu_op = d.imm_u, ALU_PASS
        elif op == OP_AUIPC:
            d.reg_write = True
            d.a_pc, d.b_imm, d.imm = True, True, d.imm_u
        elif op == OP_JAL:
            d.reg_write = d.is_jmp = d.jal_is = d.wr_pc4 = True
            d.a_pc = d.b_imm = True
            d.imm = d.imm_j
        elif op == OP_JALR:
            d.reg_write = d.is_jmp = d.wr_pc4 = d.b_imm = True
            d.imm = d.imm_i
        elif op == OP_BRANCH:
            d.is_br = d.b_imm = True
            d.imm = d.imm_b
            d.alu_op = (ALU_SLTU if f3 & 2 else ALU_SLT) if f3 & 4 else ALU_SUB
        elif op == OP_LOAD:
            d.reg_write = d.mem_read = d.b_imm = True
            d.imm = d.imm_i
        elif op == OP_STORE:
            d.mem_write = d.b_imm = True
            d.imm = d.imm_s
        elif op == OP_OPIMM:
            d.reg_write = d.b_imm = True
            d.imm = d.imm_i
            d.alu_op = {0: ALU_ADD, 1: ALU_SLL, 2: ALU_SLT, 3: ALU_SLTU,
                        4: ALU_XOR,
                        5: (ALU_SRA if (f7 >> 5) & 1 else ALU_SRL),
                        6: ALU_OR, 7: ALU_AND}.get(f3, ALU_ADD)
        elif op == OP_OP:
            d.reg_write = True
            if f7 == 0x01:
                d.is_md = True
                d.md_op = f3 & 7                     # {f3[2],f3[1:0]} == f3
            else:
                d.alu_op = {0: (ALU_SUB if (f7 >> 5) & 1 else ALU_ADD),
                            1: ALU_SLL, 2: ALU_SLT, 3: ALU_SLTU, 4: ALU_XOR,
                            5: (ALU_SRA if (f7 >> 5) & 1 else ALU_SRL),
                            6: ALU_OR, 7: ALU_AND}.get(f3, ALU_ADD)
        elif op == OP_FENCE:
            d.alu_op = ALU_PASS
        elif op == OP_SYSTEM:
            if f3 == 0:
                d.imm = d.imm_i
                if d.sys_code == 0x00000:
                    d.do_ecall = True
                elif d.sys_code == 0x00001:
                    d.do_ebreak = True
                elif d.sys_code == 0x00302:
                    d.do_mret = True
                else:
                    d.do_wfi = True
            else:
                d.is_csr = d.reg_write = True
                d.alu_op = ALU_PASS
                d.imm = ((d.rs1 & 0x1F) if (f3 & 4) else d.imm_i) & MASK32
        elif op_custom:
            d.is_epv = d.b_imm = True
            d.imm = d.imm_i
            d.is_c0 = (op == OP_CUSTOM0)
            d.epv_illegal = self._epv_illegal(d)
            if op == OP_CUSTOM1:
                d.reg_write = (f7 == EPV_F7_VDOT8)
            else:
                d.reg_write = (f3 in (EPV_F3_XMV, EPV_F3_CFGR))
        else:
            d.alu_op = ALU_PASS
        return d

    @staticmethod
    def _epv_illegal(d):
        """epv32_epv.v:69-97 decode of the CUSTOM0 / CUSTOM1 space.

        field_bad 是**逐指令类**的三条掩码（rd_is_vec / rs2_is_vec / rs1_is_vec），
        不是无条件查 rd/rs2/rs1：VDOT8、XMV、CFGR 的 [11:7] 是真 GPR，允许 0..31，
        单源类 (VRELU8/VSRA4/VPOOL2) 不查 vs2，VDOT8/VZERO 不查 vs1，
        CUSTOM0 全部不查 rs1。旧版本在这里无条件查，于是 `EPV.CFGR x11` 与
        `EPV.VDOT8 x11,...` 被误判成 illegal-instruction —— 而编译器把目的寄存器
        分到 x8 以上太常见了，整程序轨迹比对一接上就撞死在那条指令上。
        """
        if d.is_c0:
            if d.f3 not in EPV_C0_F3_OK:
                return True
            if d.f3 in EPV_RD_VEC_C0 and (d.rd >> 3) != 0:
                return True
            return d.f3 in EPV_RS2_VEC_C0 and (d.rs2 >> 3) != 0
        if (d.f3 != 0 or d.f7 not in EPV_C1_F7_OK
                or ((d.f7 in EPV_RD_VEC_C1) and (d.rd >> 3) != 0)
                or ((d.f7 in EPV_RS2_VEC_C1) and (d.rs2 >> 3) != 0)):
            return True
        return d.f7 in EPV_RS1_VEC_C1 and (d.rs1 >> 3) != 0

    # ------------------------------------------------------------------- ALU
    @staticmethod
    def alu(op, a, b):
        a, b = u32(a), u32(b)
        if op == ALU_ADD:
            return u32(a + b)
        if op == ALU_SUB:
            return u32(a - b)
        if op == ALU_SLL:
            return u32(a << (b & 0x1F))
        if op == ALU_SLT:
            return 1 if s32(a) < s32(b) else 0
        if op == ALU_SLTU:
            return 1 if a < b else 0
        if op == ALU_XOR:
            return a ^ b
        if op == ALU_SRL:
            return a >> (b & 0x1F)
        if op == ALU_SRA:
            return u32(s32(a) >> (b & 0x1F))
        if op == ALU_OR:
            return a | b
        if op == ALU_AND:
            return a & b
        if op == ALU_PASS:
            return a
        return 0

    # ------------------------------------------------ muldiv (epv32_muldiv.v)
    @staticmethod
    def muldiv(op, a, b):
        a, b = u32(a), u32(b)
        sa, sb = s32(a), s32(b)
        if op == 0:                                          # MUL
            return u32(sa * sb)
        if op == 1:                                          # MULH
            return u32((sa * sb) >> 32)
        if op == 2:                                          # MULHSU (spec f3=2)
            return u32((sa * b) >> 32)
        if op == 3:                                          # MULHU  (spec f3=3)
            return u32((a * b) >> 32)
        is_rem = op in (6, 7)
        is_u = op in (5, 7)
        if b == 0:                                           # divide by zero
            return a if is_rem else MASK32
        if (not is_u) and a == 0x8000_0000 and b == MASK32:
            return 0 if is_rem else 0x8000_0000              # INT_MIN / -1
        if is_u:
            q, r = a // b, a % b
        else:
            q = trunc_div(sa, sb)
            r = sa - q * sb
        return u32(r if is_rem else q)

    # ------------------------------------------------------- EPV vector ops
    @staticmethod
    def _vcfg_fields(vcfg):
        """epv32_epv.v:102-106: S saturates at 31; RB is the raw 8-bit field."""
        s_raw = vcfg & 0xFF
        s = 31 if s_raw > 31 else (vcfg & 0x1F)
        return s, (vcfg >> 16) & 1, (vcfg >> 17) & 1, (vcfg >> 8) & 0xFF

    def _epv_op(self, d):
        """Compute one CUSTOM0 / CUSTOM1 result.

        Returns (vec_wr, vdst, vec_value, x_wr, x_result).  LVB/SVB/CFG keep
        their side effects in _step_body because they touch the bus / vcfg.
        """
        s, rnd, sat, rb = self._vcfg_fields(self.vcfg)
        vd, vs1, vs2 = d.rd & 7, d.rs1 & 7, d.rs2 & 7
        s1, s2, sdst = self.vregs[vs1], self.vregs[vs2], self.vregs[vd]
        wv, val, xwr, xres = False, 0, False, 0

        if d.is_c0:
            if d.f3 == EPV_F3_MVX:
                g = u32(self._x(d.rs1))
                val = (g | (g << 32) | (g << 64) | (g << 96)) & MASK128
                wv = True
            elif d.f3 == EPV_F3_XMV:
                # quirk 11: 向量号在 rs2 字段 (epv32_hw.h 把 vs2 放 [24:20]、rs1 放 x0).
                xwr, xres = True, u32(s2)      # s2 = vrf[rs2f[2:0]]
            elif d.f3 == EPV_F3_CFGR:
                xwr, xres = True, self.vcfg
            return wv, vd, val, xwr, xres

        if d.f7 == EPV_F7_VDOT8:
            acc = 0
            for i in range(16):
                acc += v_lane_i8(s1, i) * v_lane_i8(s2, i)
            xwr, xres = True, u32(acc)
        elif d.f7 == EPV_F7_VMAC4:
            val = sdst
            for j in range(4):
                acc = v_lane_w(sdst, j)
                for m in range(4):
                    k = 4 * j + m
                    acc += v_lane_i8(s1, k) * v_lane_i8(s2, k)
                val = v_put_word(val, j, u32(acc))
            wv = True
        elif d.f7 in (EPV_F7_VADD8, EPV_F7_VSUB8):
            add = d.f7 == EPV_F7_VADD8
            val = 0
            for i in range(16):
                x, y = v_lane_i8(s1, i), v_lane_i8(s2, i)
                val = v_put_byte(val, i, sat8_9(x + y if add else x - y, sat))
            wv = True
        elif d.f7 == EPV_F7_VREQ4:
            val = 0
            bias = (1 << (s - 1)) if (rnd and s != 0) else 0
            rb_signed = (rb ^ 0x80) - 0x80      # quirk 12: int8 zero point
            for g in range(4):
                av, mv = v_lane_w(s1, g), v_lane_w(s2, g)
                prd = s64(av * mv)
                hi = s64(prd + (1 << 30)) >> 31
                sh = s64(hi + bias) >> s
                val = v_put_byte(val, g, sat8_64(s64(sh + rb_signed)))
            wv = True
        elif d.f7 in (EPV_F7_VMAX8, EPV_F7_VMIN8):
            want_max = d.f7 == EPV_F7_VMAX8
            val = 0
            for i in range(16):
                x, y = v_lane_i8(s1, i), v_lane_i8(s2, i)
                pick = x if ((x > y) if want_max else (x < y)) else y
                val = v_put_byte(val, i, pick & 0xFF)
            wv = True
        elif d.f7 == EPV_F7_VRELU8:
            val = 0
            for i in range(16):
                x = v_lane_i8(s1, i)
                val = v_put_byte(val, i, (0 if x < 0 else x) & 0xFF)
            wv = True
        elif d.f7 == EPV_F7_VSRA4:
            val = 0
            bias = (1 << (s - 1)) if (rnd and s != 0) else 0
            for g in range(4):
                val = v_put_word(val, g, u32((v_lane_w(s1, g) + bias) >> s))
            wv = True
        elif d.f7 == EPV_F7_VZERO:
            val, wv = 0, True
        elif d.f7 == EPV_F7_VPOOL2:
            val = 0
            for g in range(8):
                p, q = v_lane_i8(s1, 2 * g), v_lane_i8(s1, 2 * g + 1)
                val = v_put_byte(val, g, (p if p > q else q) & 0xFF)
            wv = True
        return wv, vd, val, xwr, xres

    def _epv_base(self, d):
        """EPV.LVB/SVB transfer base.  Hardware (R-type): exactly rs1 -- the
        imm field is dead (EPV_MEM_IMM_UNUSED; see quirk 17).  Setting that
        flag False revives the I-type-era offset for reproduction."""
        if EPV_MEM_IMM_UNUSED:
            return u32(self._x(d.rs1))
        raw = d.imm & 0xFFF
        off = raw if EPV_IMM_ZERO_EXTENDS else sext(raw, 12)
        return u32(self._x(d.rs1) + off)

    @staticmethod
    def _epv_stride(k):
        return (4 * k) if EPV_MEM_ADDR_STRIDE_X4 else k

    # ---------------------------------------------------------- register file
    def _x(self, i):
        return self.regs[i & 31] if (i & 31) else 0

    def _set_x(self, i, v):
        if (i & 31):
            self.regs[i & 31] = u32(v)

    # ------------------------------------------------------------------- trap
    def _enter_trap(self, sr, cause, is_irq, tval):
        """epv32_csr.v:143-149 + epv32_core.v:480.  The instruction dies."""
        mie = (self.mstatus >> 3) & 1
        self.mstatus = u32((self.mstatus & ~0x1888) | (mie << 7) | 0x1800)
        self.mepc = u32(sr.pc & 0xFFFF_FFFE)
        self.mcause = u32(((1 << 31) if is_irq else 0) | (cause & 0x1F))
        self.mtval = u32(tval)
        if is_irq:
            base = u32(self.mtvec & 0xFFFF_FFFC)
            if MIRROR_RTL_MTVEC_MODE_BIT:      # RTL: vmode_vec = mtvec[1]
                vectored = bool((self.mtvec >> 1) & 1)
            else:                              # spec: mode == 1 is vectored
                vectored = (self.mtvec & 3) == 1
            target = u32(base + 4 * (cause & 0x1F)) if vectored else base
        else:
            # quirk 4: 异常入口用 csr_mtvec_base, 低两位 MODE 被清零
            # (trap_target = irq_now ? csr_irq_target : csr_mtvec_base).
            target = u32(self.mtvec & 0xFFFF_FFFC)
        self.pc = target
        sr.trap = Trap(cause, is_irq, tval, sr.pc, target)
        sr.next_pc = target
        return sr

    def _irq_pending(self):
        """epv32_csr.v:64-78 and epv32_core.v:459: ext(11) > timer(7) > soft(3)."""
        if not ((self.mstatus >> 3) & 1):
            return None
        pend = (self.mie & self.mip) & MASK32
        if pend == 0:
            return None
        for bit in (11, 7, 3):
            if (pend >> bit) & 1:
                return bit
        return None

    # ------------------------------------------------------------------- step
    def step(self):
        """Execute exactly one retired (or trapping) instruction."""
        pc = self.pc
        instr = self._fetch(pc)
        d = self._decode(instr)
        sr = StepResult()
        sr.pc, sr.instr = pc, instr
        idx = self.steps
        self.steps += 1
        plan = None
        if self._exact_cycles:
            # CYCLE MODEL v2: place this instruction on the RTL clock BEFORE
            # the body runs -- device reads and CSR reads sample the clock.
            plan, _last = self._place_ex(d)
            self._plan = plan
            self._cur_ex = plan["active"]
            self.cycle = plan["active"]
            self._cur_cross = self._cur_memop = False
            self._cur_redirect = False
            self._cur_load_rd = d.rd if d.mem_read else None
        try:
            self._step_body(pc, instr, d, sr)
        finally:
            if plan is not None:
                self._record_prev(plan)
                base = self._last_ex if self._last_ex is not None else 1
                sr.cycles = plan["last"] - base
                self._last_ex = plan["last"]
            else:
                cyc = self._cycles_for(idx, pc, instr)
                self.cycle += cyc
                sr.cycles = cyc
        return sr

    def _cycles_for(self, idx, pc, instr):
        if self._cycle_model is not None:
            return int(self._cycle_model(self, idx, pc, instr))
        return self.cycles_per_step

    # ------------------------------------------------------ one instruction
    def _step_body(self, pc, instr, d, sr):
        rs1v, rs2v = self._x(d.rs1), self._x(d.rs2)
        alu_a = pc if d.a_pc else (d.imm if d.a_immu else rs1v)
        # epv32_core.v:254 sets d_b_imm for BRANCH, so the hardware ALU computes
        # rs1 OP branch_offset and BEQ/BNE/BLT/BGE test THAT (see header
        # deviation 4).  Golden: a branch compares the two GPR operands.
        use_imm_b = d.b_imm and not (d.is_br and not MIRROR_RTL_BRANCH_OPERAND_BUG)
        alu_b = d.imm if use_imm_b else rs2v
        alu_y = self.alu(d.alu_op, alu_a, alu_b)
        mem_addr = u32(alu_y)
        br_target = u32(pc + s32(d.imm))
        jr_target = u32((pc + s32(d.imm) if d.jal_is else u32(rs1v + d.imm))
                        & 0xFFFF_FFFE)
        f3 = d.f3
        c_ld, c_st = d.mem_read, d.mem_write
        # epv32_core.v 的 M6: 对齐档按访问宽度分三档, 且「硬件拆分」档不陷入。
        # 分组照抄 RTL, 按 funct3 而不是按位序: 1 字节 LB=0/LBU=4/SB=0 无要求,
        # 2 字节 LH=1/LHU=5/SH=1 看 addr[0], 4 字节 LW=2/SW=2 看 addr[1:0]。
        # (SW 与 LW 共用 funct3=2, 由读/写位区分 —— RV32 里 f3=6/7 的访存是 RV64
        #  的 LWU/SD, 本核判非法; 早先这里写成 f3 in (2,6), 与 RTL 的教训同源。)
        word_acc = (f3 == 2)
        half_acc = (f3 in (1, 5))
        misaligned = (c_ld or c_st) and (
            (half_acc and (mem_addr & 1))
            or (word_acc and (mem_addr & 3) != 0))
        ma_trap = misaligned and not SUPPORT_MISALIGNED
        x_wb = 4 if word_acc else (2 if half_acc else 1)
        x_cross = bool((c_ld or c_st) and SUPPORT_MISALIGNED
                       and ((mem_addr & 3) + x_wb) > 4)
        # CYCLE MODEL v2: facts the NEXT step's placement needs.  Registered
        # here because the exception chains below return early.
        plan = getattr(self, "_plan", None)
        self._cur_cross = x_cross
        self._cur_memop = bool(c_ld or c_st)
        x_hi_addr = ((mem_addr & ~3) + 4) & MASK32
        bus_err = (c_ld or c_st) and (not self.addr_ok(mem_addr)
                                      or (x_cross and not self.addr_ok(x_hi_addr)))
        fetch_err = not self.addr_ok(pc)
        ill_exc = d.illegal or (d.is_epv and d.epv_illegal)
        # M7: 与 epv32_core.v 的 br_err/jr_err 同式 —— 分支只有真的跳才判目标,
        # 且目标除「在地址图上」还要过 IALIGN=32 (jalr 已清 bit0, 所以看 bit1)。
        br_take = d.is_br and self._br_taken(d, rs1v, rs2v, alu_y)
        br_err = d.is_br and br_take and (not self.addr_ok(br_target)
                                          or bool((br_target >> 1) & 1))
        jr_err = d.is_jmp and (not self.addr_ok(jr_target)
                               or bool((jr_target >> 1) & 1))

        # ---- exception chain, priority order of epv32_core.v:425-434
        exc = None
        if ill_exc:
            exc = (EXC_ILLEGAL, instr)
        elif fetch_err:
            exc = (EXC_IAF, pc)
        elif br_err:
            exc = (EXC_IAFAIL_ALIGN, br_target)
        elif jr_err:
            exc = (EXC_IAFAIL_ALIGN, jr_target)
        elif d.do_ebreak:
            exc = (EXC_BREAK, pc)
        elif d.do_ecall:
            exc = (EXC_ECM, 0)
        elif ma_trap:
            exc = (EXC_LAMF if c_ld else EXC_SAMF, mem_addr)
        elif bus_err:
            exc = (EXC_LAF if c_ld else EXC_SAF, mem_addr)
        if exc is not None:
            self._commit_req = None
            self._cur_redirect = True           # trap redirects like a branch
            return self._enter_trap(sr, exc[0], False, exc[1])

        # ---- interrupt: taken before the EX instruction commits
        irq = self._irq_pending()
        if irq is not None:
            self._commit_req = None
            self._cur_redirect = True
            return self._enter_trap(sr, irq, True, 0)

        # =================================================== commit (ex_commit)
        tx0 = len(self.uart_tx)
        self._commit_req = None
        # NOTE: the retire count is bumped AFTER the CSR read below, so a
        # csrr of minstret / instret sees "instructions retired before me",
        # which is what the hardware's WB-stage counter holds while the reader
        # is still in EX.  quirk 9: mret never retires.
        def _retire():
            if not d.do_mret:
                # M9: 写计数器那条指令自己不计入 minstret (规范: 被写入的值
                # 会被下一条指令原样读到), 但它照样退休、照样进轨迹。mcountinhibit
                # 的 IR 位停的是 minstret。
                if not (csr_do_wr and csr_addr in CSR_COUNTER):
                    if not (self.mcountinhibit & 0x4):
                        self.n_instr += 1
                sr.retired = True

        # ---- CSR: read the old value now, the write lands after the commit
        csr_old, csr_do_wr, csr_nxt, csr_addr = 0, False, 0, None
        if d.is_csr:
            csr_addr = (instr >> 20) & 0xFFF
            cop = f3 & 3                                  # 01 RW 10 RS 11 RC
            imm_form = bool(f3 & 4)
            wdata = ((d.rs1 & 0x1F) if imm_form else rs1v) & MASK32
            csr_old = self._csr_read(csr_addr)
            csr_do_wr = cop == 1 or (cop in (2, 3)
                                     and not (wdata == 0 and not imm_form))
            csr_nxt = ((csr_old & ~wdata) if cop == 3 else
                       (csr_old | wdata) if cop == 2 else wdata) & MASK32
            sr.csr_addr, sr.csr_old = csr_addr, csr_old
        _retire()

        # ---- EPV: vector operation + vcfg + the 4-beat LVB / SVB transfer
        epv_xwr, epv_xres = False, 0
        if d.is_epv:
            sr.epv = True
            sr.vcfg = self.vcfg
            if d.is_c0 and d.f3 in (EPV_F3_LVB, EPV_F3_SVB):
                base = self._epv_base(d)
                if d.f3 == EPV_F3_LVB:
                    v = 0
                    for k in range(4):
                        if plan is not None:
                            # CYCLE MODEL v2: beat k samples the bus at its
                            # granted cycle (4 beats + any grant waits).
                            self.cycle = plan["fe"] + plan["g0"] + k
                        a = u32(base + self._epv_stride(k))
                        w = self._read_word(a)
                        v = v_put_word(v, k, w)
                        sr.loads.append((a, w))
                    # quirk 17: the LVB destination vector is the rs2 field
                    self.vregs[d.rs2 & 7] = v
                    sr.vregs_written.append(d.rs2 & 7)
                else:
                    src = self.vregs[d.rs2 & 7]
                    for k in range(4):
                        if plan is not None:
                            self.cycle = plan["fe"] + plan["g0"] + k
                        a = u32(base + self._epv_stride(k))
                        w = u32(src >> (32 * k))
                        self._write_word(a, w, 0xF)
                    # quirk 17, trace shape: the four bus beats are real and
                    # are applied above, but SVB retires with o_tr_memwr=0
                    # (idex_mem_write=0 for CUSTOM0), so the retirement trace
                    # -- and this StepResult's store records -- carry NONE of
                    # them.  The S projection therefore sees scalar stores
                    # only; SVB's effects are covered transitively through
                    # the R projection (programs that read the bytes back).
            else:
                wv, vd, val, epv_xwr, epv_xres = self._epv_op(d)
                if wv:
                    self.vregs[vd] = val & MASK128
                    sr.vregs_written.append(vd)
                if d.is_c0 and d.f3 == EPV_F3_CFG:
                    self.vcfg = u32(rs1v) & 0x0003_FFFF   # epv32_epv.v:274
                    sr.vcfg_written = True
                    sr.vcfg = self.vcfg

        # ---- EX result mux (epv32_core.v:449)
        if d.is_md:
            ex_result = self.muldiv(d.md_op, rs1v, rs2v)
        elif d.is_epv:
            ex_result = u32(epv_xres) if epv_xwr else 0
        elif d.is_csr:
            ex_result = csr_old
        elif d.wr_pc4:
            ex_result = u32(pc + 4)
        elif d.a_immu:
            ex_result = u32(d.imm)
        else:
            ex_result = u32(alu_y)

        # ---- MEM stage
        # M6 镜像: 与被核对的核共用同一条 64bit 窗口式子。读侧一律「把对象挪到
        # 窗口最低字节再按 off=0 扩展」; 写侧按字节通道掩码分成低字/高字两次写。
        load_val = None
        off_b = mem_addr & 3
        sh = 8 * off_b
        word0 = mem_addr & ~3
        if c_ld:
            # 与 RTL 同一条式子: 先把访问对象右移 8*off 挪到窗口最低字节,
            # 再一律按 off=0 扩展。早先这里给 LH/LHU 写了一套「看 ext_off 的位
            # 选 16 位切片」的近似, 于是**字内**非对齐的 lh/lhu(addr%4==1)取到了
            # 低半字 —— rv32ui/ma_data 的第 0 小节(lh at +1)就是靠逐条轨迹比对
            # 把这条抓出来的: 核给 0x201(测试要的), 模型给 0x100。
            if plan is not None:
                self.cycle = plan["active"] + 1    # load samples bus in MEM
            if x_cross:
                lo = self._read_word(word0)
                if plan is not None:
                    self.cycle = plan["active"] + 2    # second beat, next cyc
                hi = self._read_word(word0 + 4)
                raw = (((hi << 32) | lo) >> sh) & MASK32
            else:
                raw = (self._read_word(word0) >> sh) & MASK32
            if f3 == 0:
                load_val = u32(sext(raw & 0xFF, 8))
            elif f3 == 1:
                load_val = u32(sext(raw & 0xFFFF, 16))
            elif f3 == 4:
                load_val = raw & 0xFF
            elif f3 == 5:
                load_val = raw & 0xFFFF
            else:
                load_val = raw                # LW, and the f3==7 hole (quirk 5)
            sr.loads.append((mem_addr, load_val))
        if c_st:
            width = x_wb
            v = (rs2v & 0xFF) if width == 1 else ((rs2v & 0xFFFF) if width == 2
                                                  else (rs2v & MASK32))
            val64 = (v << sh) & ((1 << 64) - 1)
            be64 = (((1 << (8 * width)) - 1) << sh) & ((1 << 64) - 1)
            # be64 的 1 站在「位」上, o_dmem_be 的 1 站在「字节通道」上: 逐字节归约
            lanes = [1 if (be64 >> (8 * i)) & 0xFF else 0 for i in range(8)]
            be_lo = lanes[0] | (lanes[1] << 1) | (lanes[2] << 2) | (lanes[3] << 3)
            be_hi = lanes[4] | (lanes[5] << 1) | (lanes[6] << 2) | (lanes[7] << 3)
            if plan is not None:
                self.cycle = plan["active"] + 1    # store drives bus in MEM
            self._write_word(word0, (val64 >> 0) & MASK32, be_lo)
            if be_hi:
                if plan is not None:
                    self.cycle = plan["active"] + 2    # crossing second beat
                self._write_word(word0 + 4, (val64 >> 32) & MASK32, be_hi)
            # 退休轨迹记「这条指令按语义写了哪几个字节通道」= 两半并集 + 原始地址,
            # 与 epv32_core.v 的 memwb_be 同一条口径(对齐时 be_hi 恒 0, 退化一致)。
            sr.stores.append((mem_addr, rs2v, be_lo | be_hi))
        if d.is_csr and csr_do_wr:
            self._csr_write(csr_addr, csr_nxt)

        # ---- WB (epv32_core.v:542: a write to x0 is not a commit)
        w = load_val if c_ld else ex_result
        if d.reg_write and d.rd != 0:
            self._set_x(d.rd, w)
            sr.rd, sr.wdata = d.rd, u32(w)
        if sr.stores:
            sr.mem_addr, sr.mem_wdata, sr.mem_be = sr.stores[0]
        sr.uart_bytes = bytes(self.uart_tx[tx0:])

        # ---- PC update (epv32_core.v:480)
        if d.do_mret:
            mpie = (self.mstatus >> 7) & 1
            self.mstatus = u32((self.mstatus & ~0x1888) | (mpie << 3) | 0x80
                               | 0x1800)
            self.pc = u32(self.mepc & 0xFFFF_FFFE)
            sr.kind = "mret"
            self._cur_redirect = True
        else:
            if d.is_jmp:
                self.pc = jr_target
                self._cur_redirect = True
            elif d.is_br and self._br_taken(d, rs1v, rs2v, alu_y):
                self.pc = br_target
                self._cur_redirect = True
            else:
                self.pc = u32(pc + 4)
            sr.kind = ("epv" if d.is_epv else "csr" if d.is_csr
                       else "mem" if (c_ld or c_st) else "int")
        sr.next_pc = self.pc

        if self._commit_req is not None:
            v, self._commit_req = self._commit_req, None
            sr.halt = v
            raise SimHalt(v, sr)
        return sr

    @staticmethod
    def _br_taken(d, a, b, y):
        """epv32_core.v:398-406: BEQ/BNE test ALU(SUB)==0, BLT/BGE test the
        SLT result bit 0, BLTU/BGEU compare the forwarded operands unsigned."""
        f3 = d.f3
        eq = (y == 0)
        lt = y & 1
        if f3 == 0:
            return eq
        if f3 == 1:
            return not eq
        if f3 == 4:
            return bool(lt)
        if f3 == 5:
            return not lt
        if f3 == 6:
            return u32(a) < u32(b)
        return u32(a) >= u32(b)

    @staticmethod
    def _be_of(f3, off):
        """epv32_core.v:64 be_of, verbatim (see quirk 14 about the dead arm)."""
        if f3 == 0:
            return 1 << off
        if f3 == 1:
            return 0b1100 if (off & 1) else 0b0011
        return 0b1111

    # -------------------------------------------------------------------- run
    def run(self, max_instr, tohost_addr, max_steps=None):
        """Run until SYSC commit, a non-zero tohost, or the budget runs out.

        Trapped and interrupted instructions never retire (quirk: the RTL's
        minstret only counts ex_commit), so bounding the loop by retired
        instructions alone would spin forever on a trap loop.  `max_steps`
        caps the raw number of step() calls; it defaults to 4*max_instr + 64
        and reports halt_reason="max_steps" when it bites.
        """
        if max_steps is None:
            max_steps = 4 * max_instr + 64
        reason = "max_instr"
        start_steps = self.steps
        passed, testnum, commit_value, last_trap = False, None, None, None
        while self.n_instr < max_instr and (self.steps - start_steps) < max_steps:
            try:
                sr = self.step()
            except SimHalt as h:
                commit_value = h.value
                reason = "commit"
                passed = (commit_value == 1)
                testnum = 0 if commit_value == 1 else (commit_value >> 1)
                break
            if sr.trap is not None:
                last_trap = sr.trap
            if tohost_addr:
                th = self._ram_peek(tohost_addr)
                if th != 0:
                    passed = (th == 1)
                    testnum = 0 if th == 1 else (th >> 1)
                    reason = "tohost"
                    break
        if (self.n_instr >= max_instr and reason == "max_instr"
                or (self.steps - start_steps) >= max_steps
                and reason == "max_instr" and self.n_instr < max_instr):
            reason = "max_steps" if self.n_instr < max_instr else "max_instr"
        return Result(passed, testnum, self.n_instr,
                      bytes(self.uart_tx).decode("utf-8", "replace"),
                      reason, commit_value, last_trap)


# ==================================================================== test kit
def _fmt(v):
    """Readable 16/8/2-base rendering, so a FAIL line says *why* it failed."""
    if isinstance(v, bool):
        return "True" if v else "False"
    if isinstance(v, int):
        if v < 0:
            return "0x%08x (%d) [negative]" % (v & MASK32, v)
        if v > 0xFFFFFFFF:
            return "0x%032x (%d)" % (v, v)
        return "0x%08x (%d)" % (v, v)
    if isinstance(v, (list, tuple)):
        inner = ", ".join(_fmt(x) for x in v)
        return "(%s)" % inner if isinstance(v, tuple) else "[%s]" % inner
    return repr(v)


class _Check(object):
    """Every failure prints expected / actual / a note; nothing is bare assert."""

    def __init__(self):
        self.passed = 0
        self.failed = 0
        self.failures = []

    def ck(self, name, got, want, why=""):
        if got == want:
            self.passed += 1
            print("ok    %-64s %s" % (name, _fmt(got)))
            return True
        self.failed += 1
        print("FAIL  %s" % name)
        print("      expected: %s" % _fmt(want))
        print("      actual  : %s" % _fmt(got))
        if why:
            print("      note    : %s" % why)
        self.failures.append(name)
        return False


# ------------------------------------------------- hand assemblers (no tools)
def enc_r(f7, rs2, rs1, f3, rd, op):
    return (((f7 & 0x7F) << 25) | ((rs2 & 0x1F) << 20) | ((rs1 & 0x1F) << 15)
            | ((f3 & 7) << 12) | ((rd & 0x1F) << 7) | (op & 0x7F))


def enc_i(imm12, rs1, f3, rd, op):
    return (((imm12 & 0xFFF) << 20) | ((rs1 & 0x1F) << 15) | ((f3 & 7) << 12)
            | ((rd & 0x1F) << 7) | (op & 0x7F))


def enc_s(imm12, rs1, rs2, f3, op):
    return ((((imm12 >> 5) & 0x7F) << 25) | ((rs2 & 0x1F) << 20)
            | ((rs1 & 0x1F) << 15) | ((f3 & 7) << 12)
            | ((imm12 & 0x1F) << 7) | (op & 0x7F))


def enc_b(off, rs1, rs2, f3):
    """B-type: signed 13-bit, 2-byte-granular branch displacement."""
    o = (off >> 1) & 0xFFF
    return ((((o >> 11) & 1) << 31) | (((o >> 4) & 0x3F) << 25)
            | ((rs2 & 0x1F) << 20) | ((rs1 & 0x1F) << 15) | ((f3 & 7) << 12)
            | ((o & 0xF) << 8) | (((o >> 10) & 1) << 7) | OP_BRANCH)


def enc_u(imm20, rd, op):
    return (((imm20 & 0xFFFFF) << 12) | ((rd & 0x1F) << 7) | (op & 0x7F))


def enc_j(off, rd):
    """J-type, field by field: inst[31]=imm[20], inst[30:21]=imm[10:1],
    inst[20]=imm[11], inst[19:12]=imm[19:12]; imm[0] is implicitly 0."""
    imm = off & 0x1F_FFFF
    return ((((imm >> 20) & 1) << 31) | (((imm >> 1) & 0x3FF) << 21)
            | (((imm >> 11) & 1) << 20) | (((imm >> 12) & 0xFF) << 12)
            | ((rd & 0x1F) << 7) | OP_JAL)


def epv_c0(f3, vd, rs1, imm12, rs2=0):
    """CUSTOM0: [11:7]=vd/rd [19:15]=rs1 [24:20]=rs2/vs2 [31:20]=imm12."""
    return enc_i(imm12, rs1, f3, vd, OP_CUSTOM0) | ((rs2 & 0x1F) << 20)


def epv_c1(f7, vd, vs1, vs2, f3=0):
    """CUSTOM1 R-type: [31:25]=funct7 [24:20]=vs2 [19:15]=vs1 [14:12]=funct3."""
    return enc_r(f7, vs2, vs1, f3, vd, OP_CUSTOM1)


def bytes16(*vals):
    """Pack up to 16 int8 lanes into the 128-bit value; lane 0 = bits [7:0]."""
    v = 0
    for i, x in enumerate(vals):
        v |= (x & 0xFF) << (8 * i)
    return v


def words4(*vals):
    v = 0
    for i, x in enumerate(vals):
        v |= (x & MASK32) << (32 * i)
    return v


def lanes_w(vec):
    return [u32(vec >> (32 * j)) for j in range(4)]


def lanes_b(vec):
    return [(vec >> (8 * i)) & 0xFF for i in range(16)]
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
